roshbhatia/crysknife/previews/case-left.png

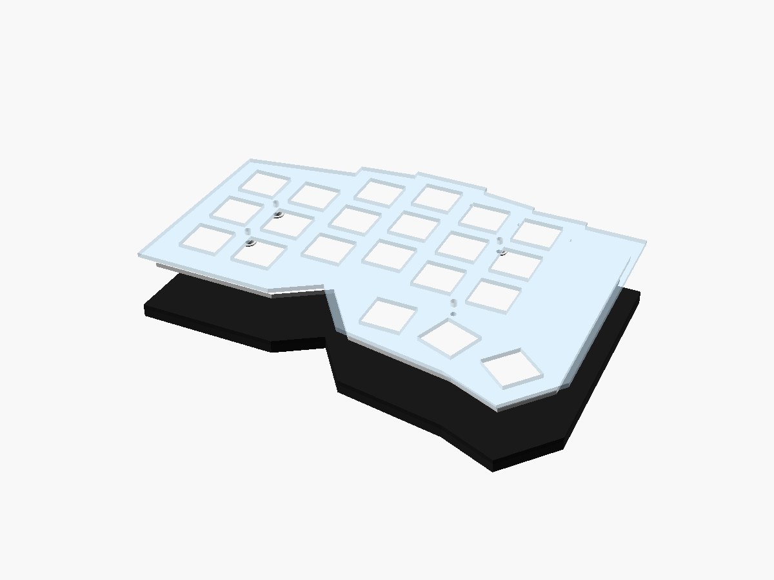
previews/case-left.png
