roshbhatia/crysknife/previews/case-right.png

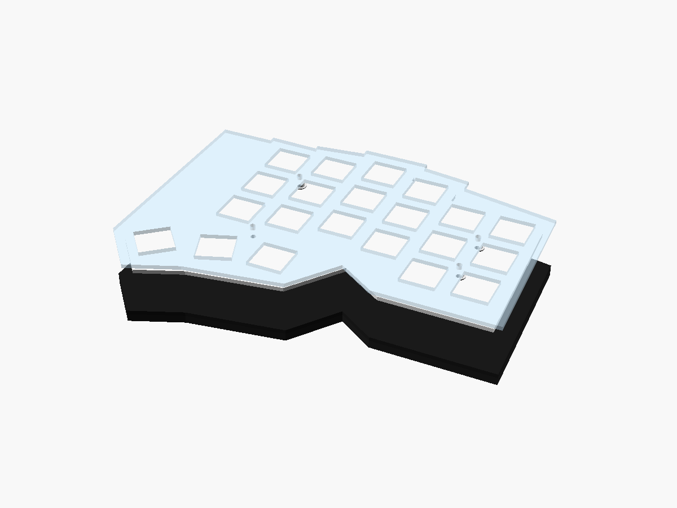
previews/case-right.png
