roshbhatia/crysknife/previews/enclosures/a-tpu-cnc-plates-section.png

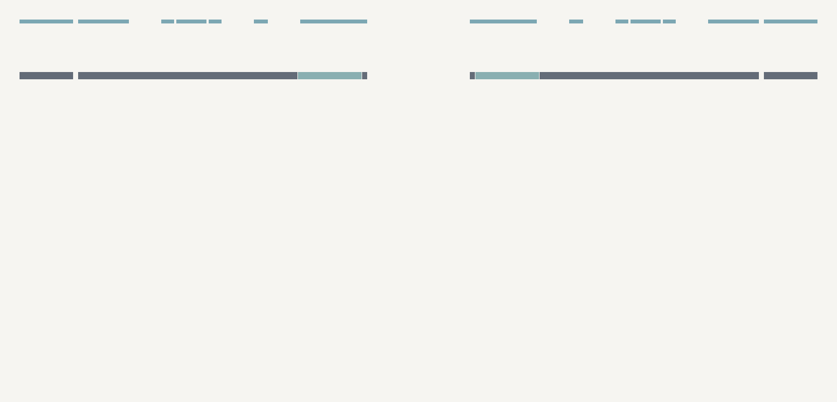
previews/enclosures/a-tpu-cnc-plates-section.png
