roshbhatia/crysknife/previews/enclosures/a-tpu-cnc-plates.png

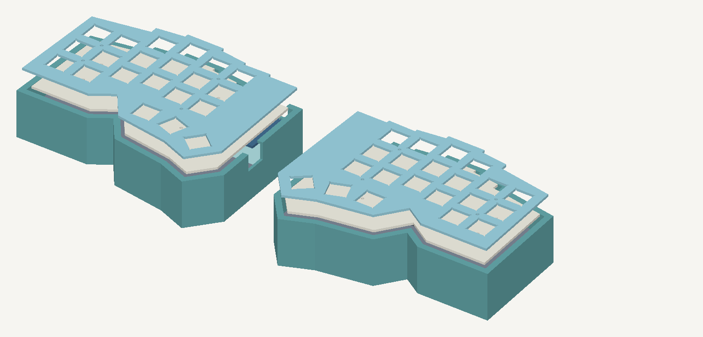
previews/enclosures/a-tpu-cnc-plates.png
