roshbhatia/crysknife/previews/enclosures/b-cnc-rigid-tray-section.png

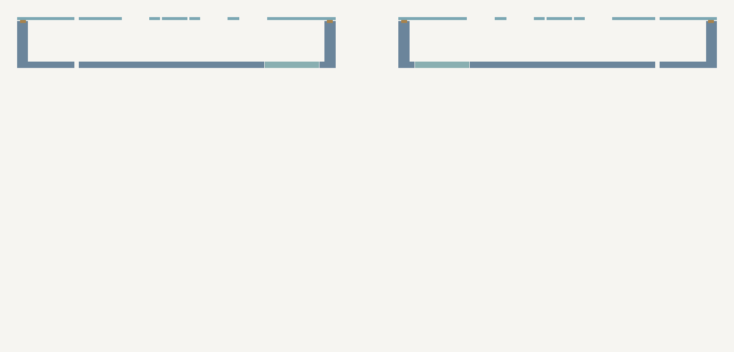
previews/enclosures/b-cnc-rigid-tray-section.png
