roshbhatia/crysknife/previews/enclosures/b-cnc-rigid-tray.png

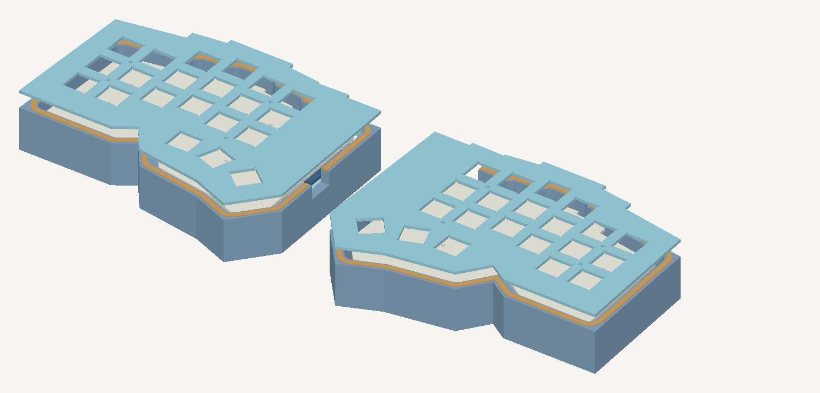
previews/enclosures/b-cnc-rigid-tray.png
