roshbhatia/crysknife/previews/enclosures/d-suspended-hybrid-section.png

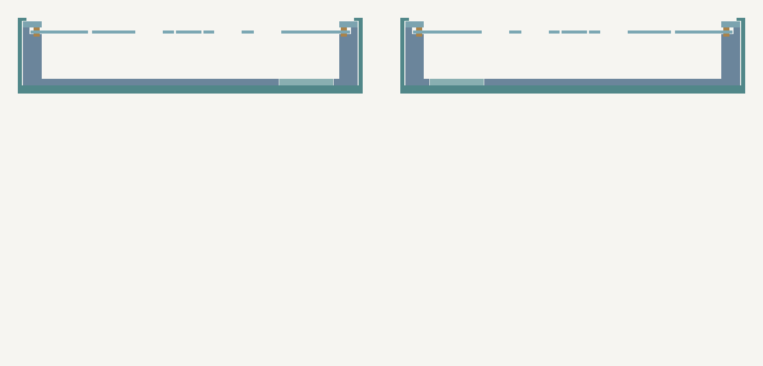
previews/enclosures/d-suspended-hybrid-section.png
