roshbhatia/crysknife/previews/enclosures/d-suspended-hybrid.png

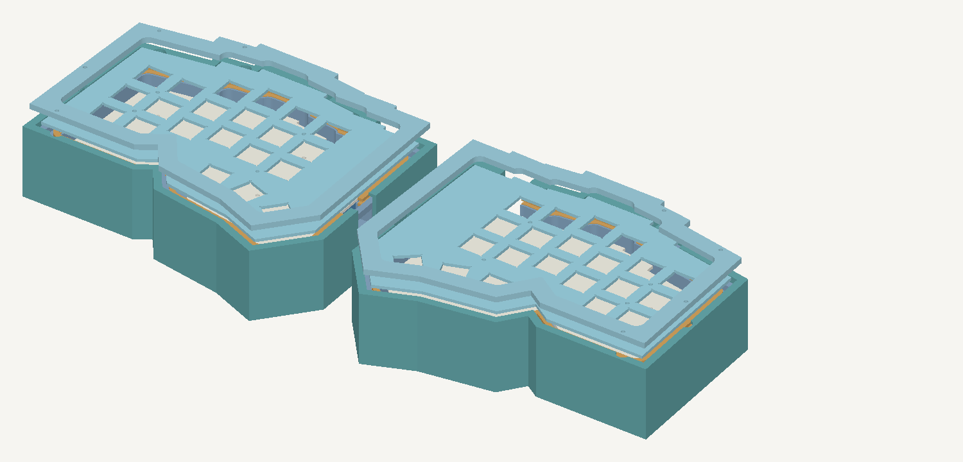
previews/enclosures/d-suspended-hybrid.png
