roshbhatia/crysknife/previews/enclosures/f-750/right-profile.png

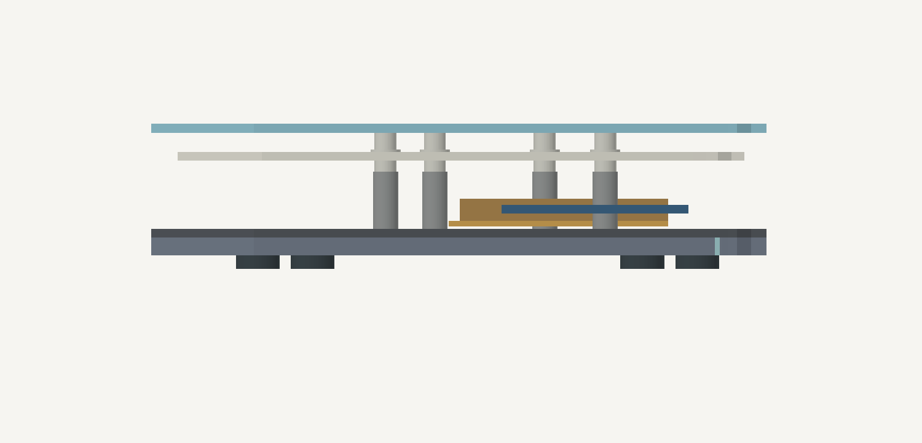
previews/enclosures/f-750/right-profile.png
