roshbhatia/crysknife/previews/enclosures/f-750/right-section.png

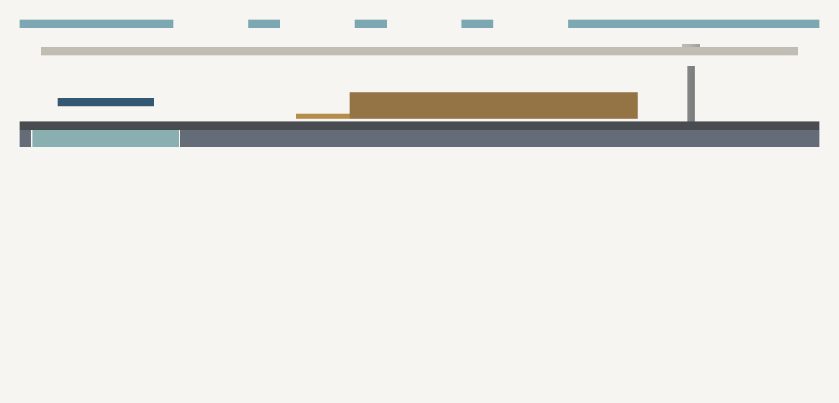
previews/enclosures/f-750/right-section.png
