roshbhatia/crysknife/previews/enclosures/heights/a-tpu-cnc-plates-side.png

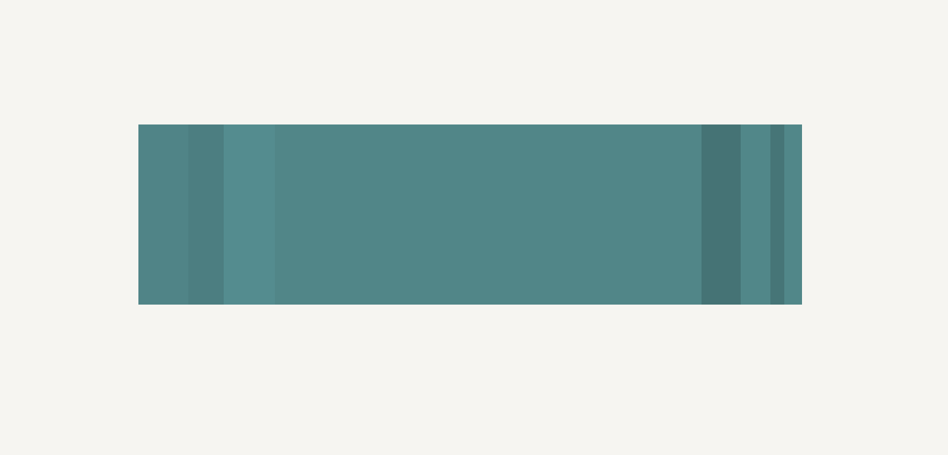
previews/enclosures/heights/a-tpu-cnc-plates-side.png
