roshbhatia/crysknife/previews/enclosures/heights/battery-750-active.png

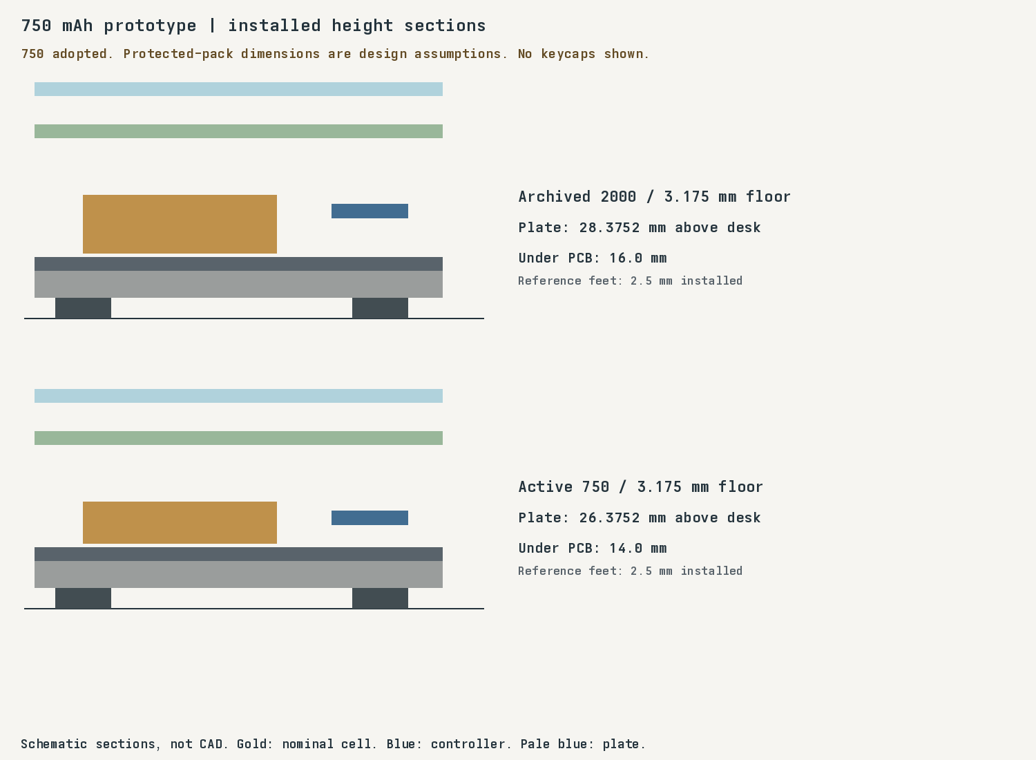
previews/enclosures/heights/battery-750-active.png
