roshbhatia/crysknife/previews/enclosures/heights/d-suspended-hybrid-side.png

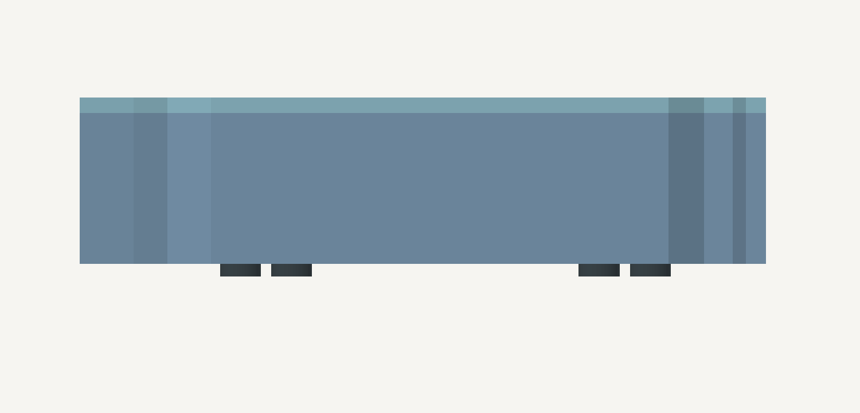
previews/enclosures/heights/d-suspended-hybrid-side.png
