roshbhatia/crysknife/previews/enclosures/heights/d-suspended-hybrid-tpu-side.png

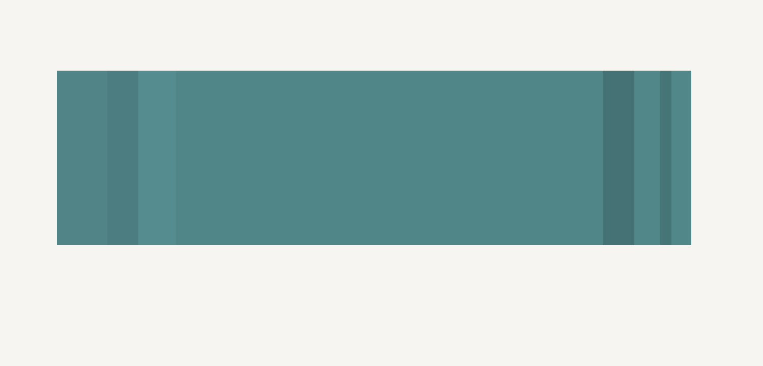
previews/enclosures/heights/d-suspended-hybrid-tpu-side.png
