roshbhatia/crysknife/previews/enclosures/heights/e-thin-rigid-sandwich-side.png

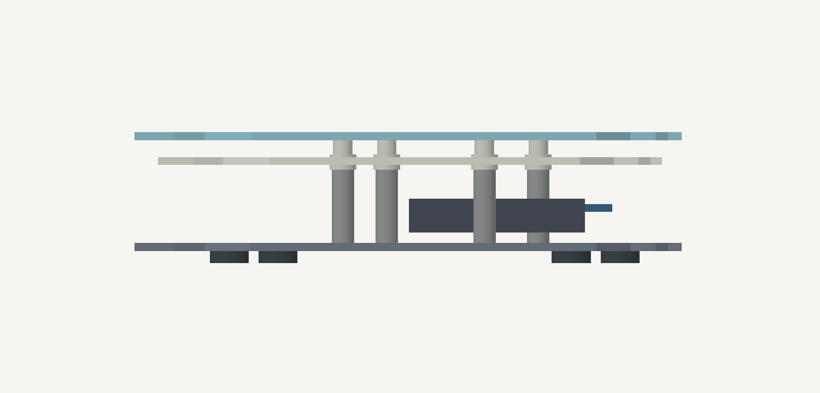
previews/enclosures/heights/e-thin-rigid-sandwich-side.png
