roshbhatia/crysknife/manufacturing/jlcpcb/left-bom.csv

Comment | Designator | Footprint | LCSC Part #
SSSS811101 | PWR1 | ceoloide:power_switch_smd_side | C109335
S2B-PH-K-S(LF)(SN) | JST1 | ceoloide:battery_connector_jst_ph_2 | C173752
CPG151101S11-16 | S1,S2,S3,S4,S5,S6,S7,S8,S9,S10,S11,S12,S13,S14,S15,S16,S17,S18,S19,S20,S21 | ceoloide:switch_mx | C41430893
PM254-1-12-Z-3.0-C | MCU1A,MCU1B | crysknife:MillMax_315_1x12 | C5156451
EVQPUL02K | RST1 | ceoloide:reset_switch_smd_side | C79175
1N4148W | D1,D2,D3,D4,D5,D6,D7,D8,D9,D10,D11,D12,D13,D14,D15,D16,D17,D18,D19,D20,D21 | ceoloide:diode_tht_sod123 | C81598
