roshbhatia/crysknife/out/3d/left-assembly.3mf

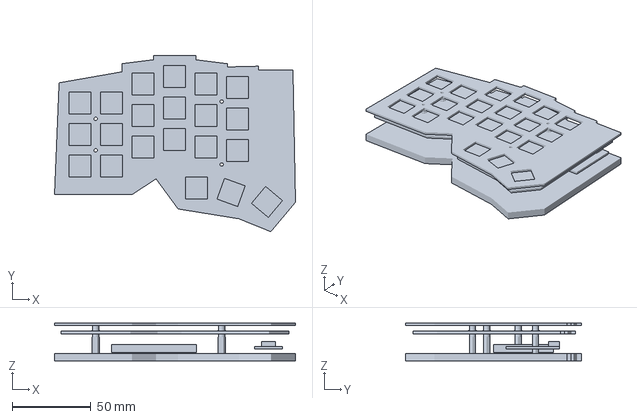
[picture p21: CAD file, 2026-10-13]
out/3d/left-assembly.3mf
153.1 x 112.0 x 23.9 mm
