roshbhatia/crysknife/manufacturing/enclosures/b-cnc-rigid-tray/left-tray.step

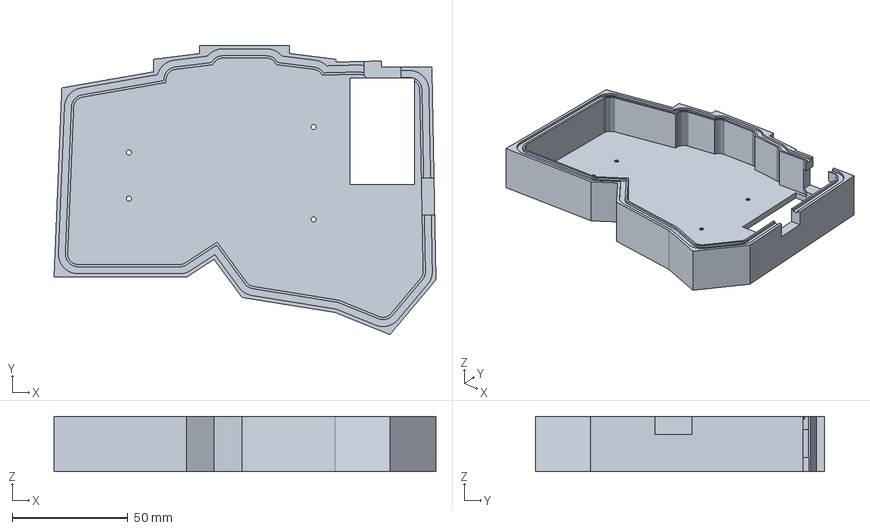
[picture p22: CAD file, 2026-10-13]
manufacturing/enclosures/b-cnc-rigid-tray/left-tray.step
165.4 x 125.2 x 24.0 mm
