roshbhatia/crysknife/manufacturing/enclosures/c-printed-tray-plate/left-tray.step

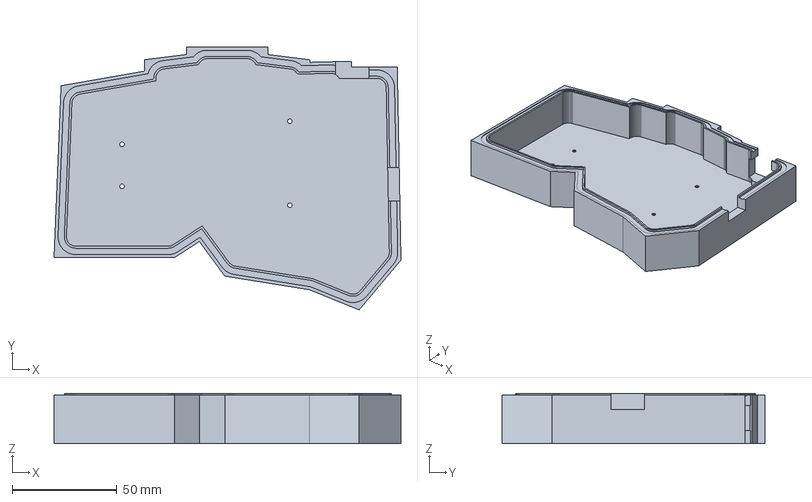
[picture p23: CAD file, 2026-10-13]
manufacturing/enclosures/c-printed-tray-plate/left-tray.step
165.4 x 125.2 x 24.0 mm
