roshbhatia/crysknife/manufacturing/enclosures/coupons/cnc-switch-fit.step

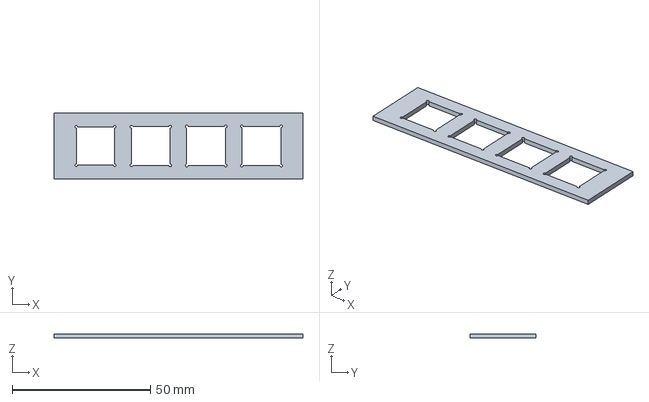
[picture p24: CAD file, 2026-10-13]
manufacturing/enclosures/coupons/cnc-switch-fit.step
90.0 x 24.0 x 1.60 mm
