roshbhatia/crysknife/manufacturing/enclosures/d-suspended-hybrid/right-top.step

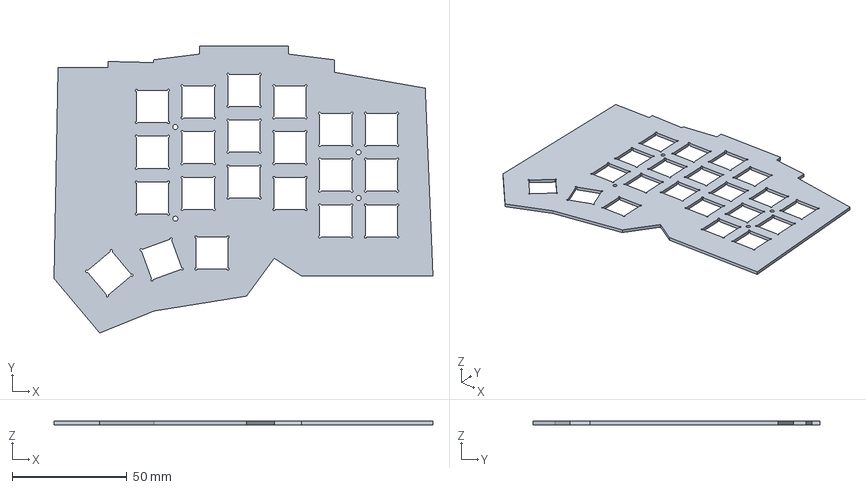
[picture p25: CAD file, 2026-10-13]
manufacturing/enclosures/d-suspended-hybrid/right-top.step
165.4 x 125.2 x 1.60 mm
