roshbhatia/crysknife/manufacturing/jlc3dp/left-sleeve.3mf

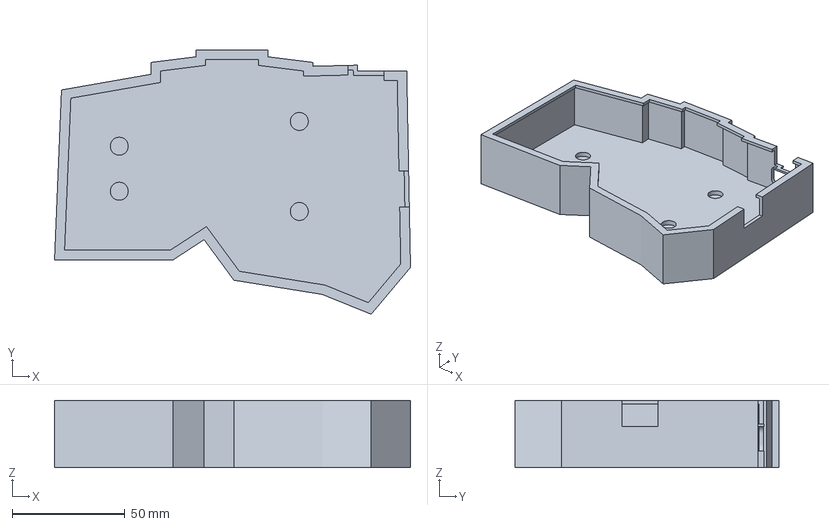
[picture p27: CAD file, 2026-10-13]
manufacturing/jlc3dp/left-sleeve.3mf
158.2 x 117.5 x 29.9 mm
