roshbhatia/crysknife/manufacturing/sendcutsend/left-bottom-flat.dxf

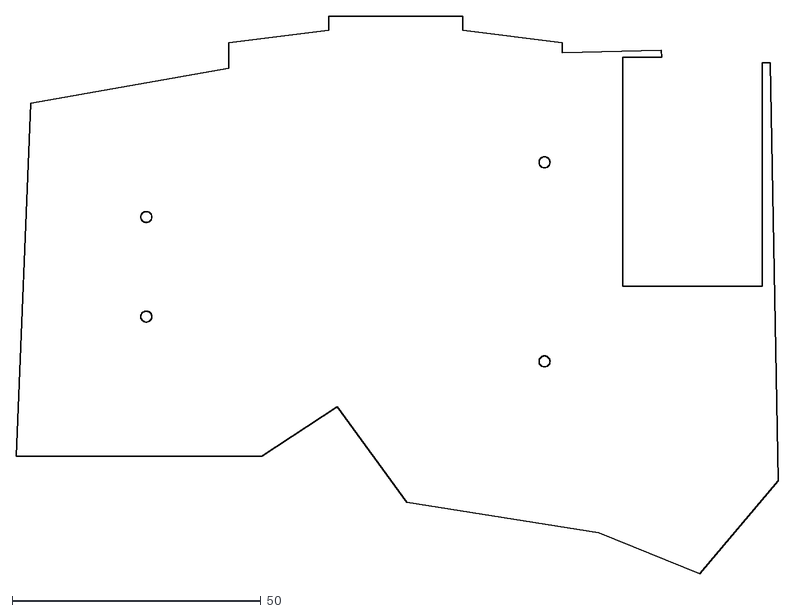
[picture p28: CAD file, 2026-10-13]
manufacturing/sendcutsend/left-bottom-flat.dxf
153.1 x 112.0
