roshbhatia/crysknife/out/3d/right-metal-bottom.3mf

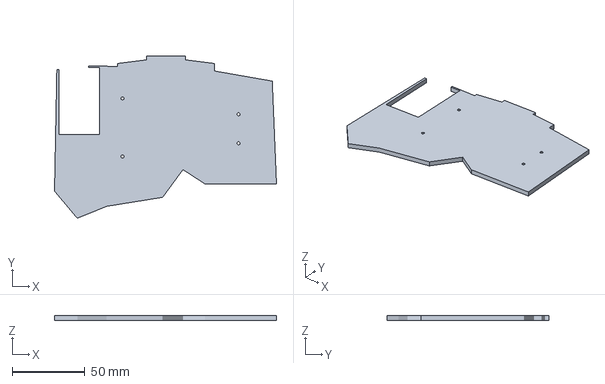
[picture p29: CAD file, 2026-10-13]
out/3d/right-metal-bottom.3mf
153.1 x 112.0 x 3.17 mm
