roshbhatia/crysknife/manufacturing/enclosures/b-cnc-rigid-tray/left-rf-insert.step

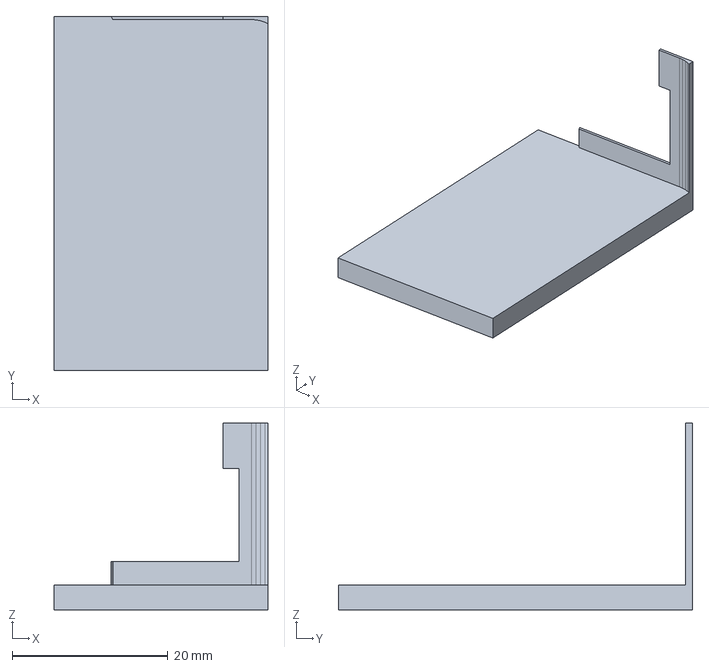
[picture p30: CAD file, 2026-10-13]
manufacturing/enclosures/b-cnc-rigid-tray/left-rf-insert.step
27.5 x 45.5 x 24.0 mm
