roshbhatia/crysknife/manufacturing/enclosures/c-printed-tray-plate/right-lower-gasket.step

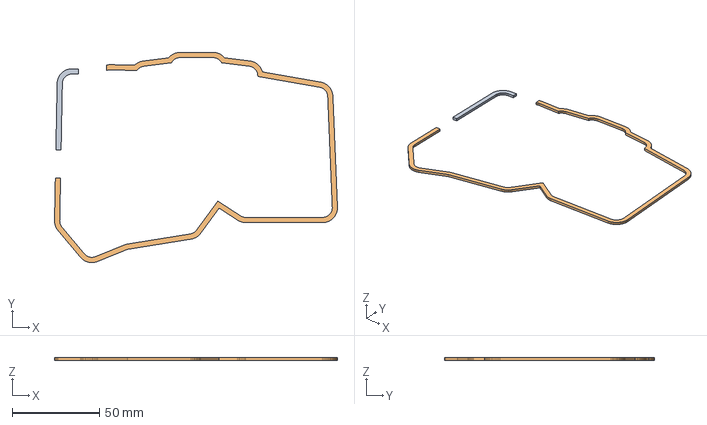
[picture p31: CAD file, 2026-10-13]
manufacturing/enclosures/c-printed-tray-plate/right-lower-gasket.step
161.9 x 120.2 x 1.50 mm
