roshbhatia/crysknife/manufacturing/enclosures/coupons/resin-switch-fit.step

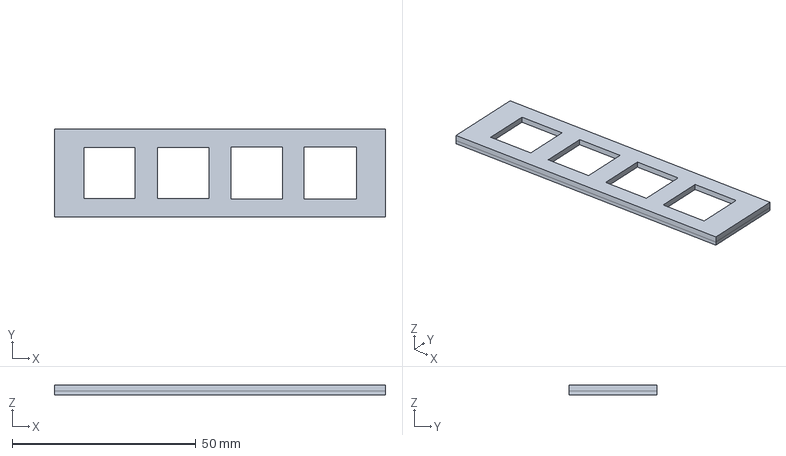
[picture p32: CAD file, 2026-10-13]
manufacturing/enclosures/coupons/resin-switch-fit.step
90.0 x 24.0 x 2.60 mm
