roshbhatia/crysknife/manufacturing/sendcutsend/right-bottom-flat.dxf

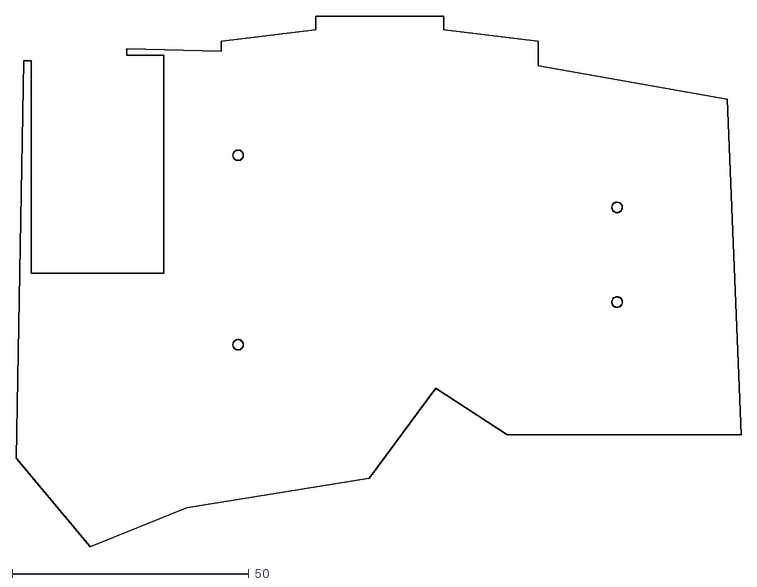
[picture p33: CAD file, 2026-10-13]
manufacturing/sendcutsend/right-bottom-flat.dxf
153.1 x 112.0
