roshbhatia/crysknife/manufacturing/enclosures/c-printed-tray-plate/left-top.step

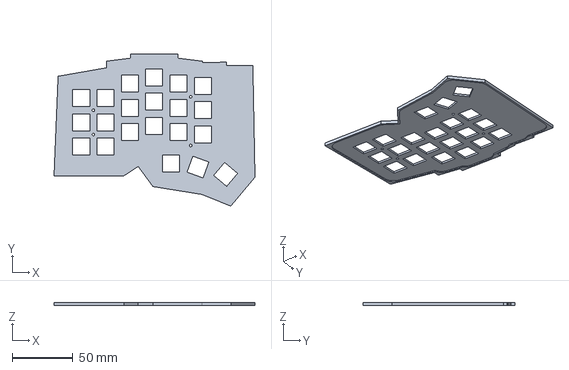
[picture p34: CAD file, 2026-10-13]
manufacturing/enclosures/c-printed-tray-plate/left-top.step
165.4 x 125.2 x 2.60 mm
