roshbhatia/crysknife/manufacturing/enclosures/d-suspended-hybrid/left-sleeve.step

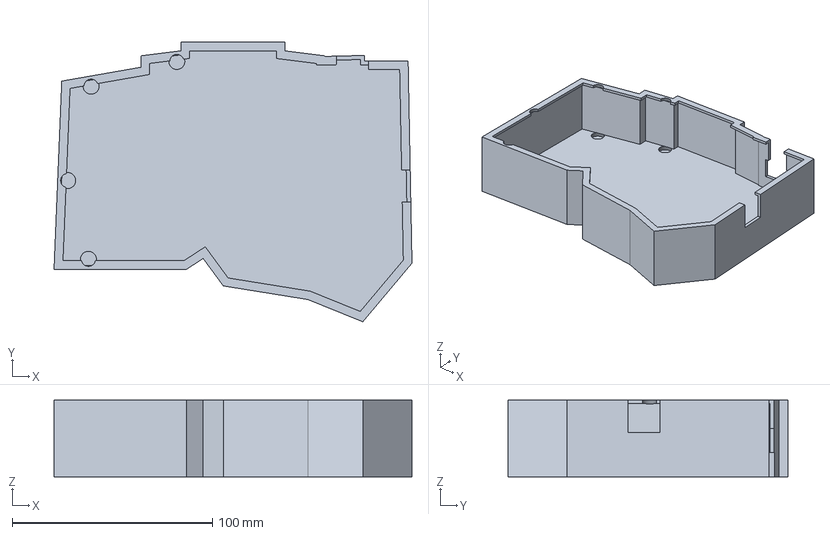
[picture p35: CAD file, 2026-10-13]
manufacturing/enclosures/d-suspended-hybrid/left-sleeve.step
178.7 x 139.5 x 38.4 mm
