roshbhatia/crysknife/manufacturing/enclosures/f-750-rigid-sandwich/right-rf-insert.step

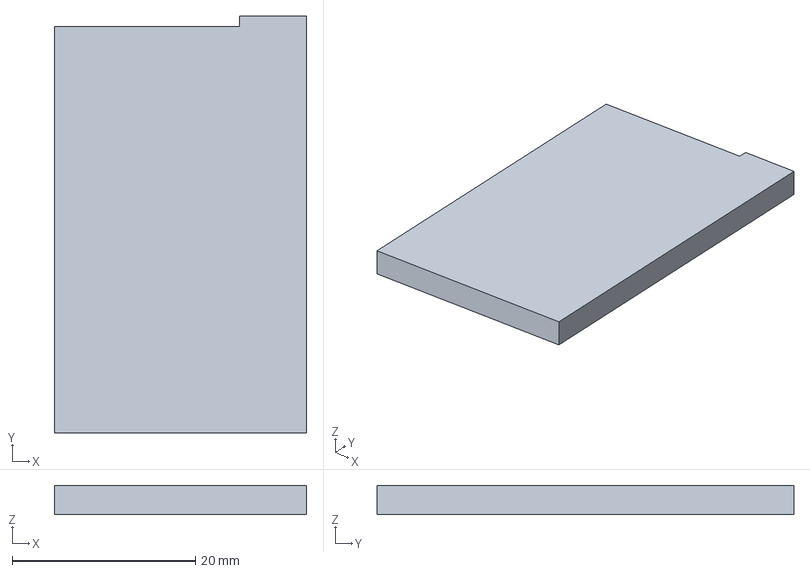
[picture p36: CAD file, 2026-10-13]
manufacturing/enclosures/f-750-rigid-sandwich/right-rf-insert.step
27.5 x 45.5 x 3.17 mm
