roshbhatia/crysknife/manufacturing/jlc3dp/left-bottom.3mf

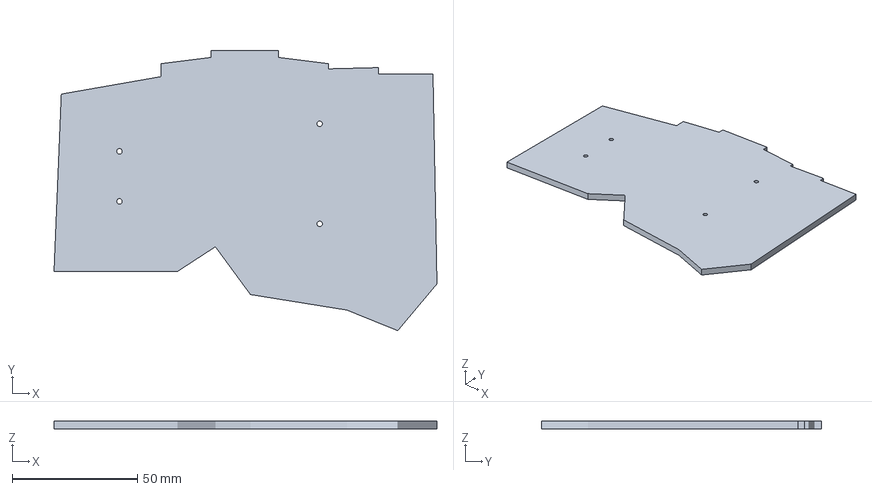
[picture p37: CAD file, 2026-10-09]
manufacturing/jlc3dp/left-bottom.3mf
153.1 x 112.0 x 3.17 mm
