roshbhatia/crysknife/manufacturing/sendcutsend/left-rf-insert.dxf

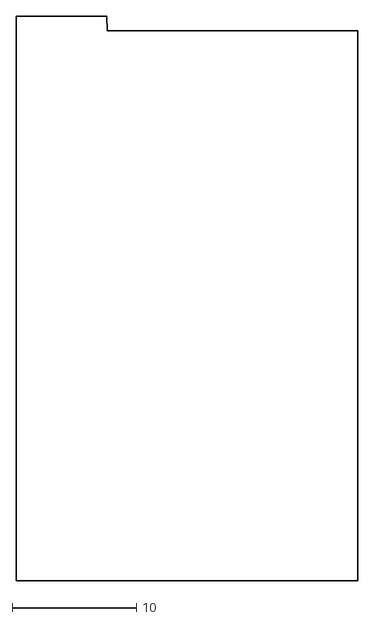
[picture p38: CAD file, 2026-10-13]
manufacturing/sendcutsend/left-rf-insert.dxf
27.5 x 45.5
