roshbhatia/crysknife/manufacturing/enclosures/d-suspended-hybrid/left-rf-insert.step

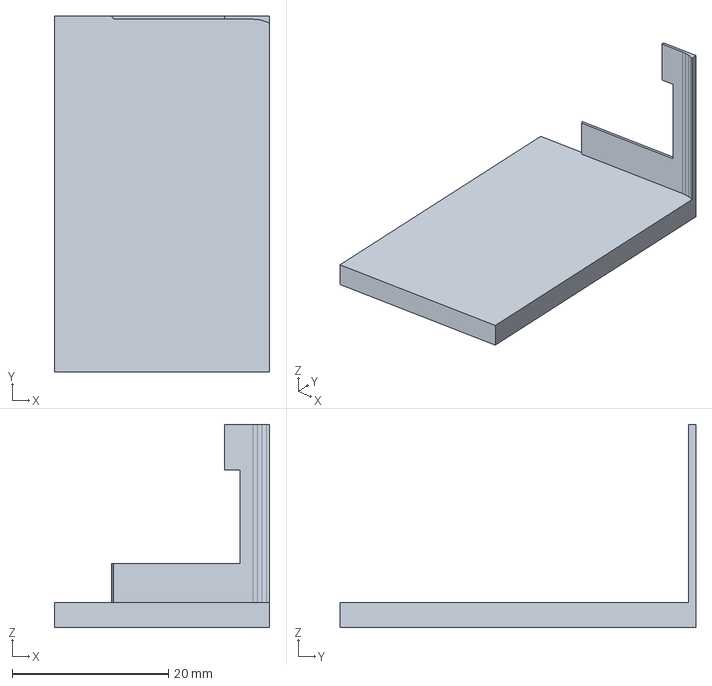
[picture p39: CAD file, 2026-10-13]
manufacturing/enclosures/d-suspended-hybrid/left-rf-insert.step
27.5 x 45.5 x 26.0 mm
