roshbhatia/crysknife/manufacturing/jlc3dp/right-plate.3mf

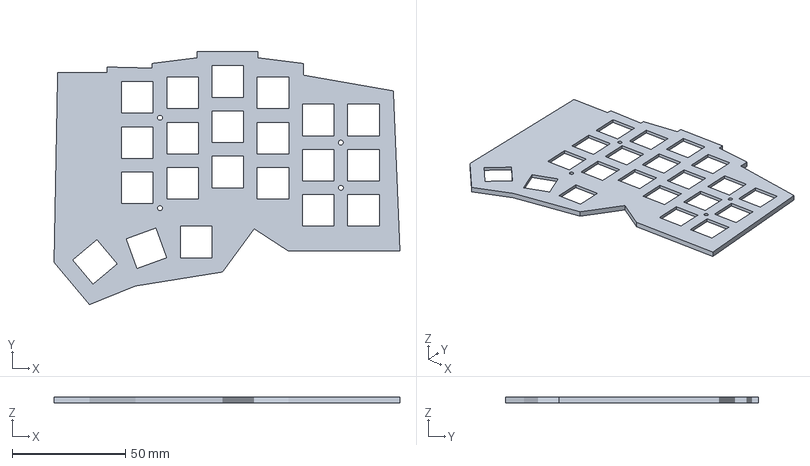
[picture p40: CAD file, 2026-10-09]
manufacturing/jlc3dp/right-plate.3mf
153.1 x 112.0 x 2.60 mm
