roshbhatia/crysknife/manufacturing/sendcutsend/right-rf-insert.dxf

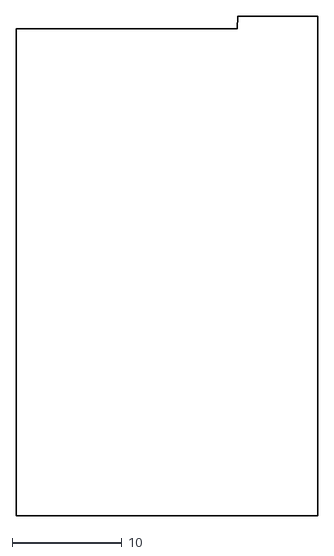
[picture p41: CAD file, 2026-10-13]
manufacturing/sendcutsend/right-rf-insert.dxf
27.5 x 45.5
