roshbhatia/crysknife/manufacturing/sendcutsend/right-plate.dxf

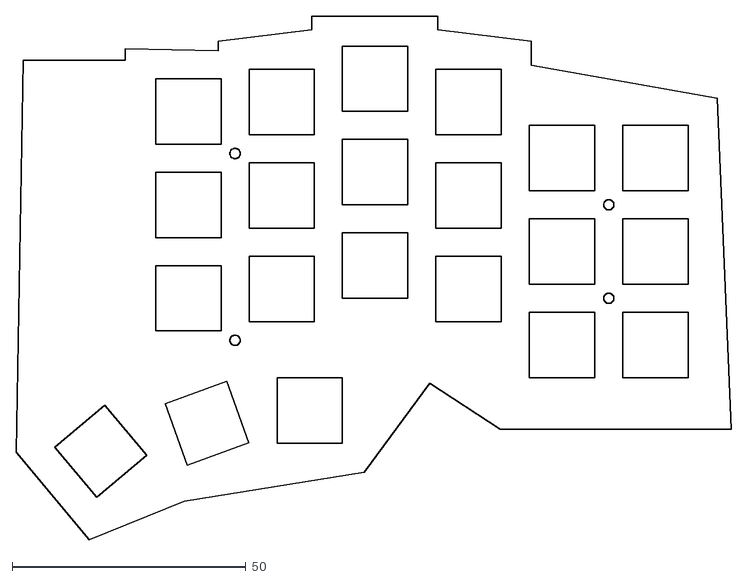
[picture p42: CAD file, 2026-10-09]
manufacturing/sendcutsend/right-plate.dxf
153.1 x 112.0
