roshbhatia/crysknife/manufacturing/enclosures/f-750-rigid-sandwich/right-top.step

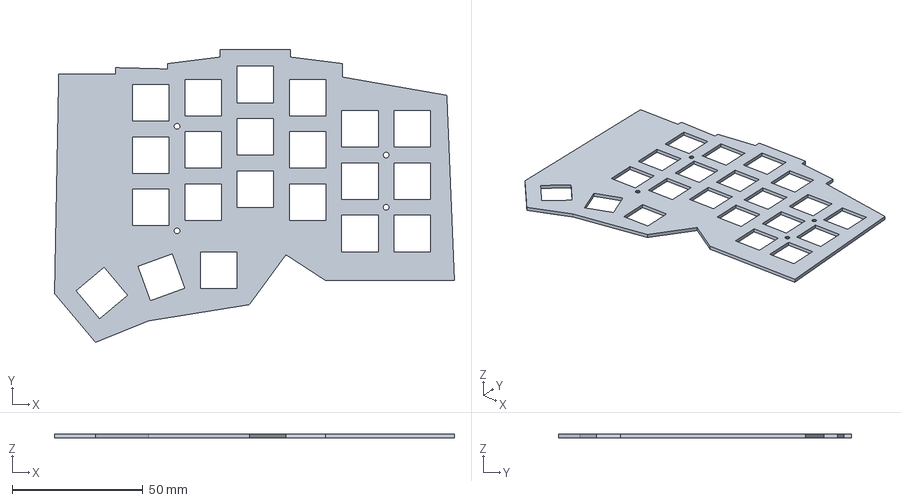
[picture p43: CAD file, 2026-10-13]
manufacturing/enclosures/f-750-rigid-sandwich/right-top.step
153.1 x 112.0 x 1.60 mm
