roshbhatia/crysknife/manufacturing/sendcutsend/left-plate.dxf

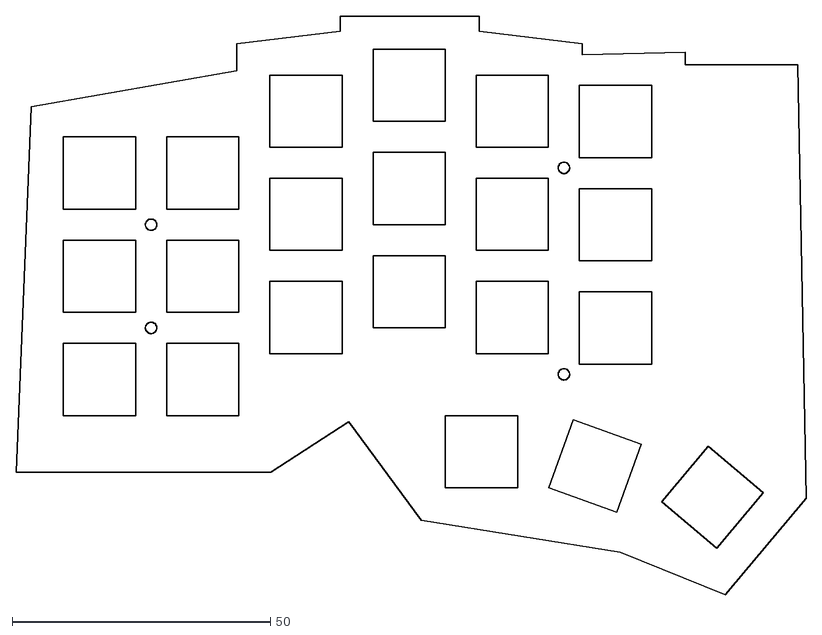
[picture p44: CAD file, 2026-10-09]
manufacturing/sendcutsend/left-plate.dxf
153.1 x 112.0
