roshbhatia/crysknife/manufacturing/sendcutsend/right-damping.dxf

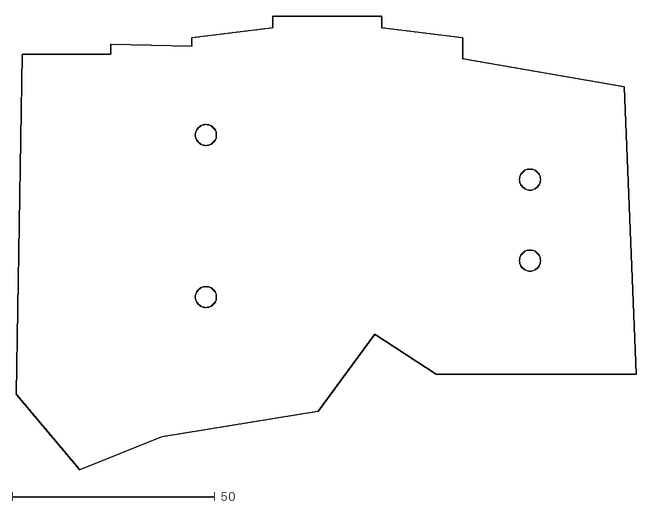
[picture p45: CAD file, 2026-10-09]
manufacturing/sendcutsend/right-damping.dxf
153.1 x 112.0
