roshbhatia/crysknife/manufacturing/sendcutsend/left-damping.dxf

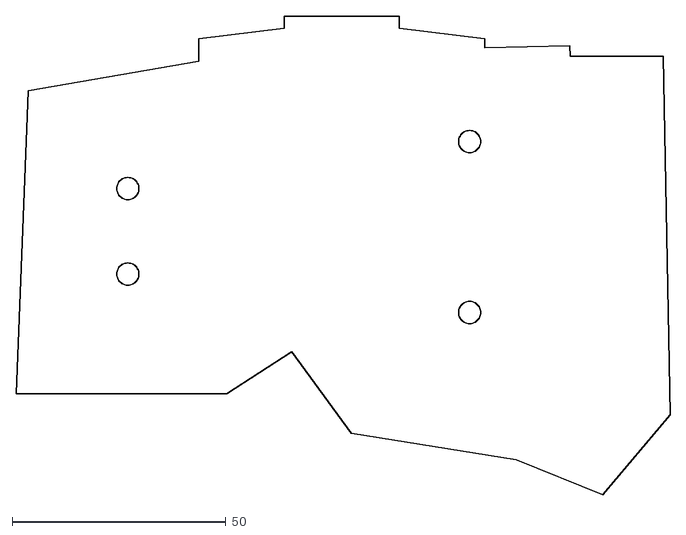
[picture p46: CAD file, 2026-10-09]
manufacturing/sendcutsend/left-damping.dxf
153.1 x 112.0
