roshbhatia/crysknife/manufacturing/enclosures/a-tpu-cnc-plates/right-sleeve.3mf

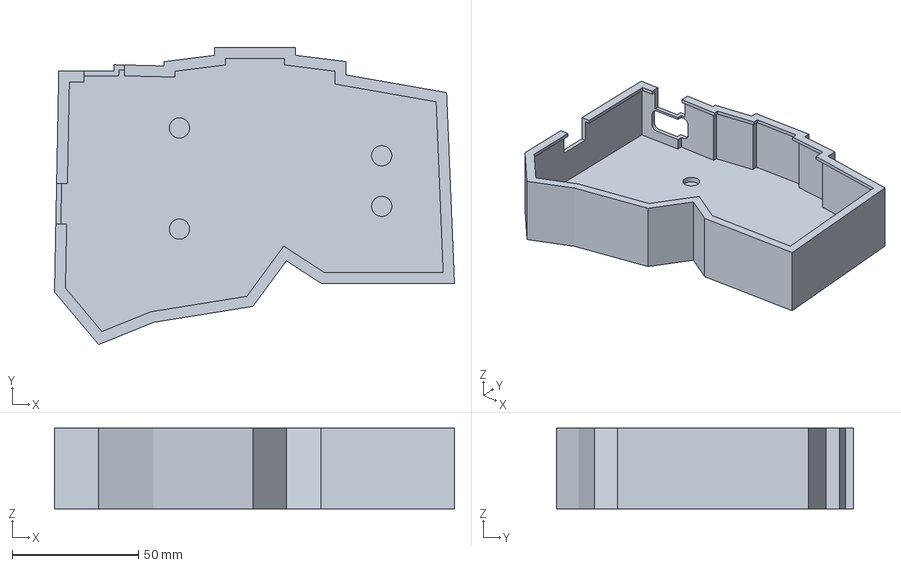
[picture p47: CAD file, 2026-10-09]
manufacturing/enclosures/a-tpu-cnc-plates/right-sleeve.3mf
158.2 x 117.5 x 31.9 mm
