roshbhatia/crysknife/manufacturing/enclosures/d-suspended-hybrid/left-tray.step

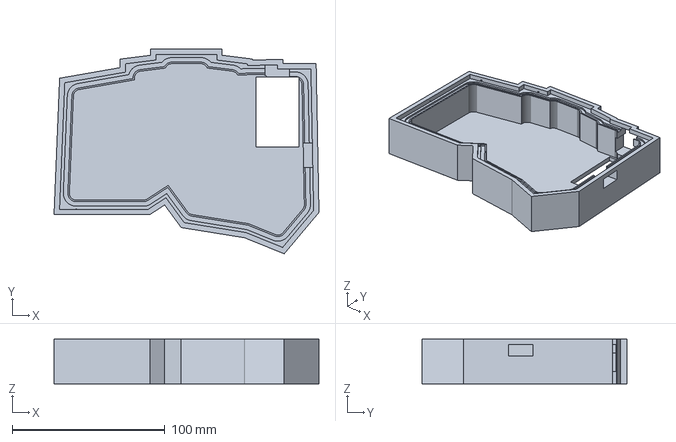
[picture p48: CAD file, 2026-10-13]
manufacturing/enclosures/d-suspended-hybrid/left-tray.step
173.5 x 134.0 x 29.4 mm
