roshbhatia/crysknife/manufacturing/sendcutsend/switch-fit-coupon.dxf

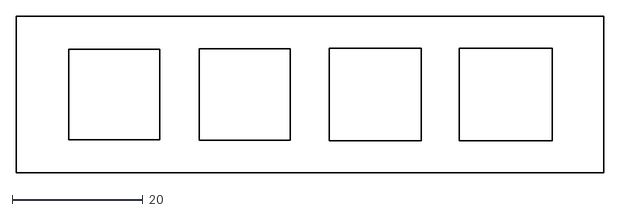
[picture p49: CAD file, 2026-10-09]
manufacturing/sendcutsend/switch-fit-coupon.dxf
90.0 x 24.0
