roshbhatia/crysknife/manufacturing/enclosures/d-suspended-hybrid/right-frame.step

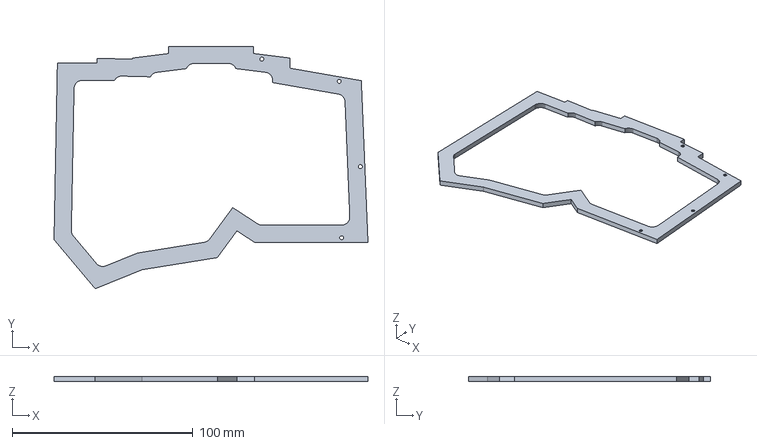
[picture p50: CAD file, 2026-10-13]
manufacturing/enclosures/d-suspended-hybrid/right-frame.step
173.5 x 134.0 x 3.00 mm
