roshbhatia/crysknife/case/parameters.scad

bottom_thickness = 3.175;
plate_thickness = 1.6002;
standoff_height = 12;
standoff_shim = 2;
standoff_shim_diameter = 4;
pcb_thickness = 1.6;
plate_to_pcb_gap = 3.5;
outline_expansion = 4;
bolt_diameter = 2.2;
switch_cutout = 14;
damping_thickness = 1.6002;
damping_bolt_diameter = 5.2;
standoff_diameter = 4.7;
standoff_across_flats = 4;
upper_spacer_height = 3;
upper_spacer_shim = 0.5;
upper_spacer_diameter = 4;
washer_diameter = 5.5;
top_screw_length = 12;
bottom_screw_length = 6;
screw_head_washer = 0.5;
standoff_thread_depth = 5;
controller_gap = 8;
controller_board_thickness = 1.6;
controller_component_height = 3;
controller_width = 18;
controller_length = 34;
