roshbhatia/crysknife/case/battery.scad

battery_nominal = [50, 34, 4];
battery_protected = [54, 38, 5];
battery_reserved = [64, 40, 6.5];
battery_component_reservation = 4.4;
battery_foam = 0.5;
battery_cover = 0.5;
