roshbhatia/crysknife/case/geometry.scad

left_geometry = [[[-72.4310476, -28.742944300000005], [-69.8210476, 34.742055699999995], [-29.821047599999986, 41.74305569999999], [-29.821047599999986, 46.742055699999995], [-9.821047599999986, 49.242055699999995], [-9.821047599999986, 51.6120557], [9.128952400000003, 51.6120557], [9.128952400000003, 49.242055699999995], [29.128952400000003, 46.742055699999995], [29.128952400000003, 44.1090557], [49.1289524, 44.6120557], [49.1819524, 42.242055699999995], [70.9319524, 42.242055699999995], [72.4310476, -36.29116690000001], [59.57529539999999, -51.61205570000001], [41.5456772, -44.3100719], [4.158952400000004, -38.2929443], [-11.126047599999993, -17.47294430000001], [-28.4310476, -28.742944300000005]], [[-60.4310476, -14.742944300000005, 0.0], [-60.4310476, 5.257055699999995, 0.0], [-60.4310476, 25.257055699999995, 0.0], [-40.4310476, -14.742944300000005, 0.0], [-40.4310476, 5.257055699999995, 0.0], [-40.4310476, 25.257055699999995, 0.0], [-20.4310476, -2.742944300000005, 0.0], [-20.4310476, 17.257055699999995, 0.0], [-20.4310476, 37.257055699999995, 0.0], [-0.4310475999999994, 2.257055699999995, 0.0], [-0.4310475999999994, 22.257055699999995, 0.0], [-0.4310475999999994, 42.257055699999995, 0.0], [19.5689524, -2.742944300000005, 0.0], [19.5689524, 17.257055699999995, 0.0], [19.5689524, 37.257055699999995, 0.0], [39.5689524, -4.742944300000005, 0.0], [39.5689524, 15.257055699999995, 0.0], [39.5689524, 35.257055699999995, 0.0], [13.5689524, -28.742944300000005, 0.0], [35.5689524, -31.492944300000005, -20.0], [58.34272709999999, -37.523735200000004, 50.0]], [[-50.4310476, 15.257055699999995], [-50.4310476, -4.742944300000005], [29.5689524, 26.257055699999995], [29.5689524, -13.742944300000005]], [59.27295240000001, 24.387055699999998], [59.27295240000001, 39.9570557], [68.8189524, -3.742944300000005], [-72.4310476, -51.61205570000001, 72.4310476, 51.6120557], [-8.4310476, 17.757055699999995], 2.2];
right_geometry = [[[72.4310476, -28.742944300000005], [69.82104759999999, 34.742055699999995], [29.821047599999986, 41.74305569999999], [29.821047599999986, 46.742055699999995], [9.821047599999986, 49.242055699999995], [9.821047599999986, 51.6120557], [-9.128952400000003, 51.6120557], [-9.128952400000003, 49.242055699999995], [-29.128952400000003, 46.742055699999995], [-29.128952400000003, 44.1090557], [-49.1289524, 44.6120557], [-49.1819524, 42.242055699999995], [-70.9319524, 42.242055699999995], [-72.4310476, -36.29116690000001], [-59.57529539999999, -51.61205570000001], [-41.5456772, -44.3100719], [-4.158952400000004, -38.2929443], [11.126047599999993, -17.47294430000001], [28.4310476, -28.742944300000005]], [[60.4310476, -14.742944300000005, 0.0], [60.4310476, 5.257055699999995, 0.0], [60.4310476, 25.257055699999995, 0.0], [40.4310476, -14.742944300000005, 0.0], [40.4310476, 5.257055699999995, 0.0], [40.4310476, 25.257055699999995, 0.0], [20.4310476, -2.742944300000005, 0.0], [20.4310476, 17.257055699999995, 0.0], [20.4310476, 37.257055699999995, 0.0], [0.4310475999999994, 2.257055699999995, 0.0], [0.4310475999999994, 22.257055699999995, 0.0], [0.4310475999999994, 42.257055699999995, 0.0], [-19.5689524, -2.742944300000005, 0.0], [-19.5689524, 17.257055699999995, 0.0], [-19.5689524, 37.257055699999995, 0.0], [-39.5689524, -4.742944300000005, 0.0], [-39.5689524, 15.257055699999995, 0.0], [-39.5689524, 35.257055699999995, 0.0], [-13.5689524, -28.742944300000005, 0.0], [-35.5689524, -31.492944300000005, 20.0], [-58.34272709999999, -37.523735200000004, -50.0]], [[50.4310476, 15.257055699999995], [50.4310476, -4.742944300000005], [-29.5689524, 26.257055699999995], [-29.5689524, -13.742944300000005]], [-59.27295240000001, 24.387055699999998], [-59.27295240000001, 39.9570557], [-68.8189524, -3.742944300000005], [-72.4310476, -51.61205570000001, 72.4310476, 51.6120557], [8.4310476, 17.757055699999995], 2.2];
