roshbhatia/crysknife/(list of files, cad)

Other CAD files:
out/3d/right-assembly.3mf
manufacturing/enclosures/d-suspended-hybrid/right-lower-gasket.step
manufacturing/enclosures/f-750-rigid-sandwich/right-bottom.step
manufacturing/jlc3dp/right-sleeve.3mf
out/3d/left-metal-bottom.3mf
manufacturing/enclosures/b-cnc-rigid-tray/left-lower-gasket.step
manufacturing/enclosures/b-cnc-rigid-tray/right-top.step
manufacturing/enclosures/c-printed-tray-plate/left-lower-gasket.step
manufacturing/enclosures/f-750-rigid-sandwich/left-rf-insert.step
manufacturing/enclosures/a-tpu-cnc-plates/right-pmma-bottom.step
manufacturing/enclosures/b-cnc-rigid-tray/right-lower-gasket.step
manufacturing/enclosures/c-printed-tray-plate/right-top.step
manufacturing/enclosures/d-suspended-hybrid/right-upper-gasket.step
manufacturing/enclosures/f-750-rigid-sandwich/left-damping.step
manufacturing/jlc3dp/left-plate.3mf
out/3d/right-printed-sleeve.3mf
manufacturing/enclosures/a-tpu-cnc-plates/left-pmma-bottom.step
manufacturing/enclosures/b-cnc-rigid-tray/right-tray.step
manufacturing/enclosures/c-printed-tray-plate/right-tray.step
manufacturing/enclosures/d-suspended-hybrid/right-rf-insert.step
manufacturing/jlc3dp/right-bottom.3mf
manufacturing/enclosures/b-cnc-rigid-tray/right-rf-insert.step
manufacturing/enclosures/d-suspended-hybrid/left-top.step
manufacturing/enclosures/f-750-rigid-sandwich/left-bottom.step
manufacturing/enclosures/b-cnc-rigid-tray/left-top.step
manufacturing/enclosures/d-suspended-hybrid/right-sleeve.step
manufacturing/enclosures/f-750-rigid-sandwich/left-top.step
out/3d/right-bottom.3mf
out/3d/left-plate.3mf
manufacturing/enclosures/a-tpu-cnc-plates/left-sleeve.3mf
manufacturing/enclosures/d-suspended-hybrid/left-upper-gasket.step
manufacturing/enclosures/d-suspended-hybrid/left-lower-gasket.step
manufacturing/enclosures/d-suspended-hybrid/right-tray.step
manufacturing/enclosures/d-suspended-hybrid/left-frame.step
case/tray-geometry.scad
manufacturing/enclosures/a-tpu-cnc-plates/left-bottom.dxf
manufacturing/enclosures/a-tpu-cnc-plates/left-bottom.step
manufacturing/enclosures/a-tpu-cnc-plates/left-bottom.stl
manufacturing/enclosures/a-tpu-cnc-plates/left-pmma-bottom.stl
manufacturing/enclosures/a-tpu-cnc-plates/left-rf-insert.step
manufacturing/enclosures/a-tpu-cnc-plates/left-rf-insert.stl
manufacturing/enclosures/a-tpu-cnc-plates/left-sleeve.stl
manufacturing/enclosures/a-tpu-cnc-plates/left-top.dxf
manufacturing/enclosures/a-tpu-cnc-plates/left-top.step
manufacturing/enclosures/a-tpu-cnc-plates/left-top.stl
manufacturing/enclosures/a-tpu-cnc-plates/right-bottom.dxf
manufacturing/enclosures/a-tpu-cnc-plates/right-bottom.step
manufacturing/enclosures/a-tpu-cnc-plates/right-bottom.stl
manufacturing/enclosures/a-tpu-cnc-plates/right-pmma-bottom.stl
manufacturing/enclosures/a-tpu-cnc-plates/right-rf-insert.step
manufacturing/enclosures/a-tpu-cnc-plates/right-rf-insert.stl
manufacturing/enclosures/a-tpu-cnc-plates/right-sleeve.stl
manufacturing/enclosures/a-tpu-cnc-plates/right-top.dxf
manufacturing/enclosures/a-tpu-cnc-plates/right-top.step
manufacturing/enclosures/a-tpu-cnc-plates/right-top.stl
manufacturing/enclosures/b-cnc-rigid-tray/left-lower-gasket.dxf
manufacturing/enclosures/b-cnc-rigid-tray/left-lower-gasket.stl
manufacturing/enclosures/b-cnc-rigid-tray/left-rf-insert.stl
manufacturing/enclosures/b-cnc-rigid-tray/left-top.dxf
manufacturing/enclosures/b-cnc-rigid-tray/left-top.stl
manufacturing/enclosures/b-cnc-rigid-tray/left-tray.stl
manufacturing/enclosures/b-cnc-rigid-tray/right-lower-gasket.dxf
manufacturing/enclosures/b-cnc-rigid-tray/right-lower-gasket.stl
manufacturing/enclosures/b-cnc-rigid-tray/right-rf-insert.stl
manufacturing/enclosures/b-cnc-rigid-tray/right-top.dxf
manufacturing/enclosures/b-cnc-rigid-tray/right-top.stl
manufacturing/enclosures/b-cnc-rigid-tray/right-tray.stl
manufacturing/enclosures/c-printed-tray-plate/left-lower-gasket.dxf
manufacturing/enclosures/c-printed-tray-plate/left-lower-gasket.stl
manufacturing/enclosures/c-printed-tray-plate/left-top.dxf
manufacturing/enclosures/c-printed-tray-plate/left-top.stl
manufacturing/enclosures/c-printed-tray-plate/left-tray.stl
manufacturing/enclosures/c-printed-tray-plate/right-lower-gasket.dxf
manufacturing/enclosures/c-printed-tray-plate/right-lower-gasket.stl
manufacturing/enclosures/c-printed-tray-plate/right-top.dxf
manufacturing/enclosures/c-printed-tray-plate/right-top.stl
manufacturing/enclosures/c-printed-tray-plate/right-tray.stl
manufacturing/enclosures/coupons/cnc-switch-fit.dxf
manufacturing/enclosures/coupons/cnc-switch-fit.stl
manufacturing/enclosures/coupons/resin-switch-fit.dxf
manufacturing/enclosures/coupons/resin-switch-fit.stl
manufacturing/enclosures/d-suspended-hybrid/left-frame.stl
manufacturing/enclosures/d-suspended-hybrid/left-lower-gasket.dxf
manufacturing/enclosures/d-suspended-hybrid/left-lower-gasket.stl
manufacturing/enclosures/d-suspended-hybrid/left-rf-insert.stl
manufacturing/enclosures/d-suspended-hybrid/left-sleeve.stl
manufacturing/enclosures/d-suspended-hybrid/left-top.dxf
manufacturing/enclosures/d-suspended-hybrid/left-top.stl
manufacturing/enclosures/d-suspended-hybrid/left-tray.stl
manufacturing/enclosures/d-suspended-hybrid/left-upper-gasket.dxf
manufacturing/enclosures/d-suspended-hybrid/left-upper-gasket.stl
manufacturing/enclosures/d-suspended-hybrid/right-frame.stl
manufacturing/enclosures/d-suspended-hybrid/right-lower-gasket.dxf
manufacturing/enclosures/d-suspended-hybrid/right-lower-gasket.stl
manufacturing/enclosures/d-suspended-hybrid/right-rf-insert.stl
manufacturing/enclosures/d-suspended-hybrid/right-sleeve.stl
manufacturing/enclosures/d-suspended-hybrid/right-top.dxf
manufacturing/enclosures/d-suspended-hybrid/right-top.stl
manufacturing/enclosures/d-suspended-hybrid/right-tray.stl
manufacturing/enclosures/d-suspended-hybrid/right-upper-gasket.dxf
manufacturing/enclosures/d-suspended-hybrid/right-upper-gasket.stl
manufacturing/enclosures/e-thin-rigid-sandwich/left-bottom.dxf
manufacturing/enclosures/e-thin-rigid-sandwich/left-bottom.step
manufacturing/enclosures/e-thin-rigid-sandwich/left-bottom.stl
manufacturing/enclosures/e-thin-rigid-sandwich/left-rf-insert.dxf
manufacturing/enclosures/e-thin-rigid-sandwich/left-rf-insert.step
manufacturing/enclosures/e-thin-rigid-sandwich/left-rf-insert.stl
manufacturing/enclosures/e-thin-rigid-sandwich/left-top.dxf
manufacturing/enclosures/e-thin-rigid-sandwich/left-top.step
manufacturing/enclosures/e-thin-rigid-sandwich/left-top.stl
manufacturing/enclosures/e-thin-rigid-sandwich/right-bottom.dxf
manufacturing/enclosures/e-thin-rigid-sandwich/right-bottom.step
manufacturing/enclosures/e-thin-rigid-sandwich/right-bottom.stl
manufacturing/enclosures/e-thin-rigid-sandwich/right-rf-insert.dxf
manufacturing/enclosures/e-thin-rigid-sandwich/right-rf-insert.step
manufacturing/enclosures/e-thin-rigid-sandwich/right-rf-insert.stl
manufacturing/enclosures/e-thin-rigid-sandwich/right-top.dxf
manufacturing/enclosures/e-thin-rigid-sandwich/right-top.step
manufacturing/enclosures/e-thin-rigid-sandwich/right-top.stl
manufacturing/enclosures/f-750-rigid-sandwich/left-bottom.dxf
manufacturing/enclosures/f-750-rigid-sandwich/left-bottom.stl
manufacturing/enclosures/f-750-rigid-sandwich/left-damping.dxf
manufacturing/enclosures/f-750-rigid-sandwich/left-damping.stl
manufacturing/enclosures/f-750-rigid-sandwich/left-rf-insert.dxf
manufacturing/enclosures/f-750-rigid-sandwich/left-rf-insert.stl
manufacturing/enclosures/f-750-rigid-sandwich/left-top.dxf
manufacturing/enclosures/f-750-rigid-sandwich/left-top.stl
manufacturing/enclosures/f-750-rigid-sandwich/right-bottom.dxf
manufacturing/enclosures/f-750-rigid-sandwich/right-bottom.stl
manufacturing/enclosures/f-750-rigid-sandwich/right-damping.dxf
manufacturing/enclosures/f-750-rigid-sandwich/right-damping.stl
manufacturing/enclosures/f-750-rigid-sandwich/right-rf-insert.dxf
manufacturing/enclosures/f-750-rigid-sandwich/right-rf-insert.stl
manufacturing/enclosures/f-750-rigid-sandwich/right-top.dxf
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
