roshbhatia/crysknife/previews/enclosures/c-printed-tray-plate-section.png

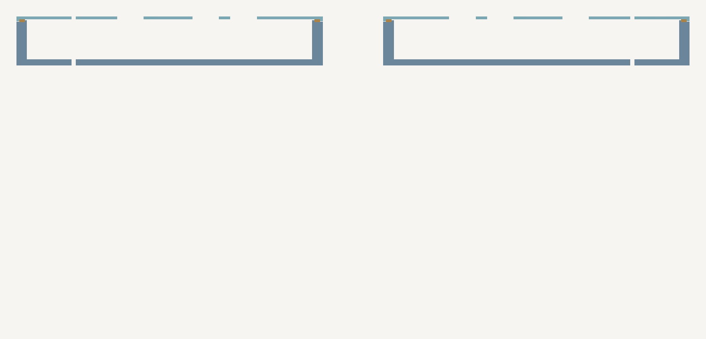
previews/enclosures/c-printed-tray-plate-section.png
