roshbhatia/crysknife/previews/enclosures/f-750/left-assembled.png

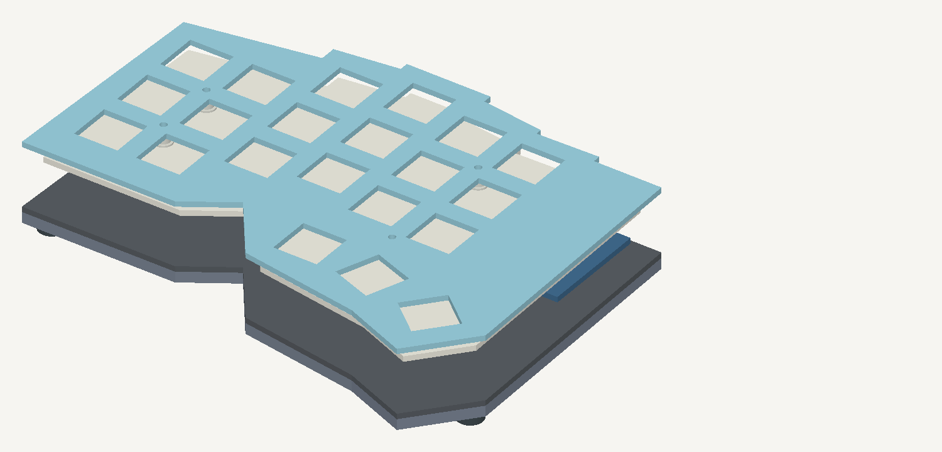
previews/enclosures/f-750/left-assembled.png
