roshbhatia/crysknife/previews/enclosures/f-750/right-assembled.png

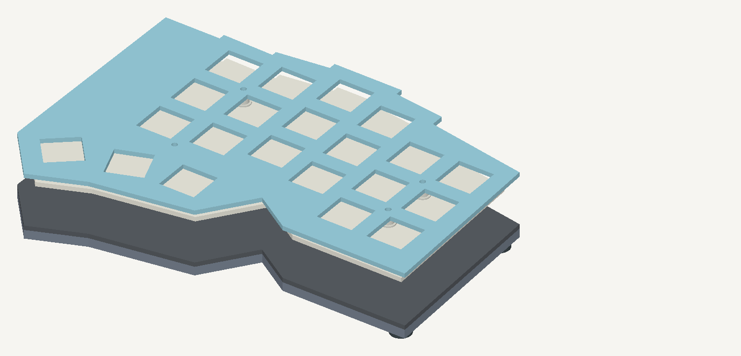
previews/enclosures/f-750/right-assembled.png
