roshbhatia/crysknife/previews/printed-case-right.png

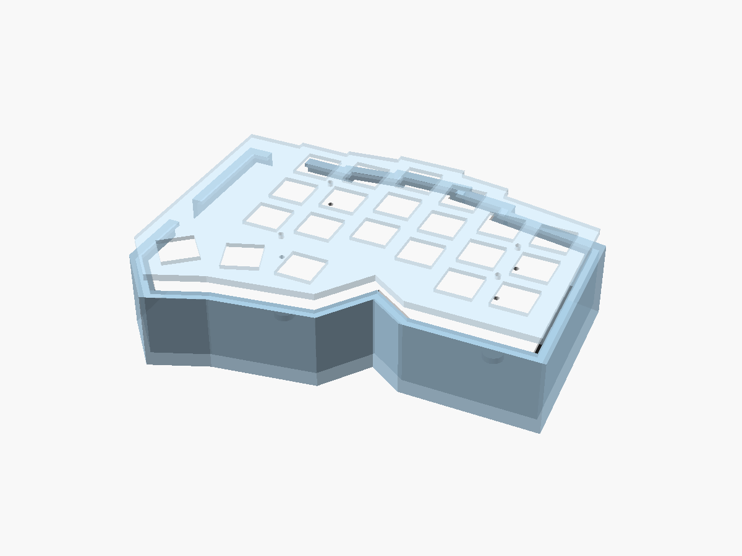
previews/printed-case-right.png
