roshbhatia/crysknife/out/kicad/left.pdf

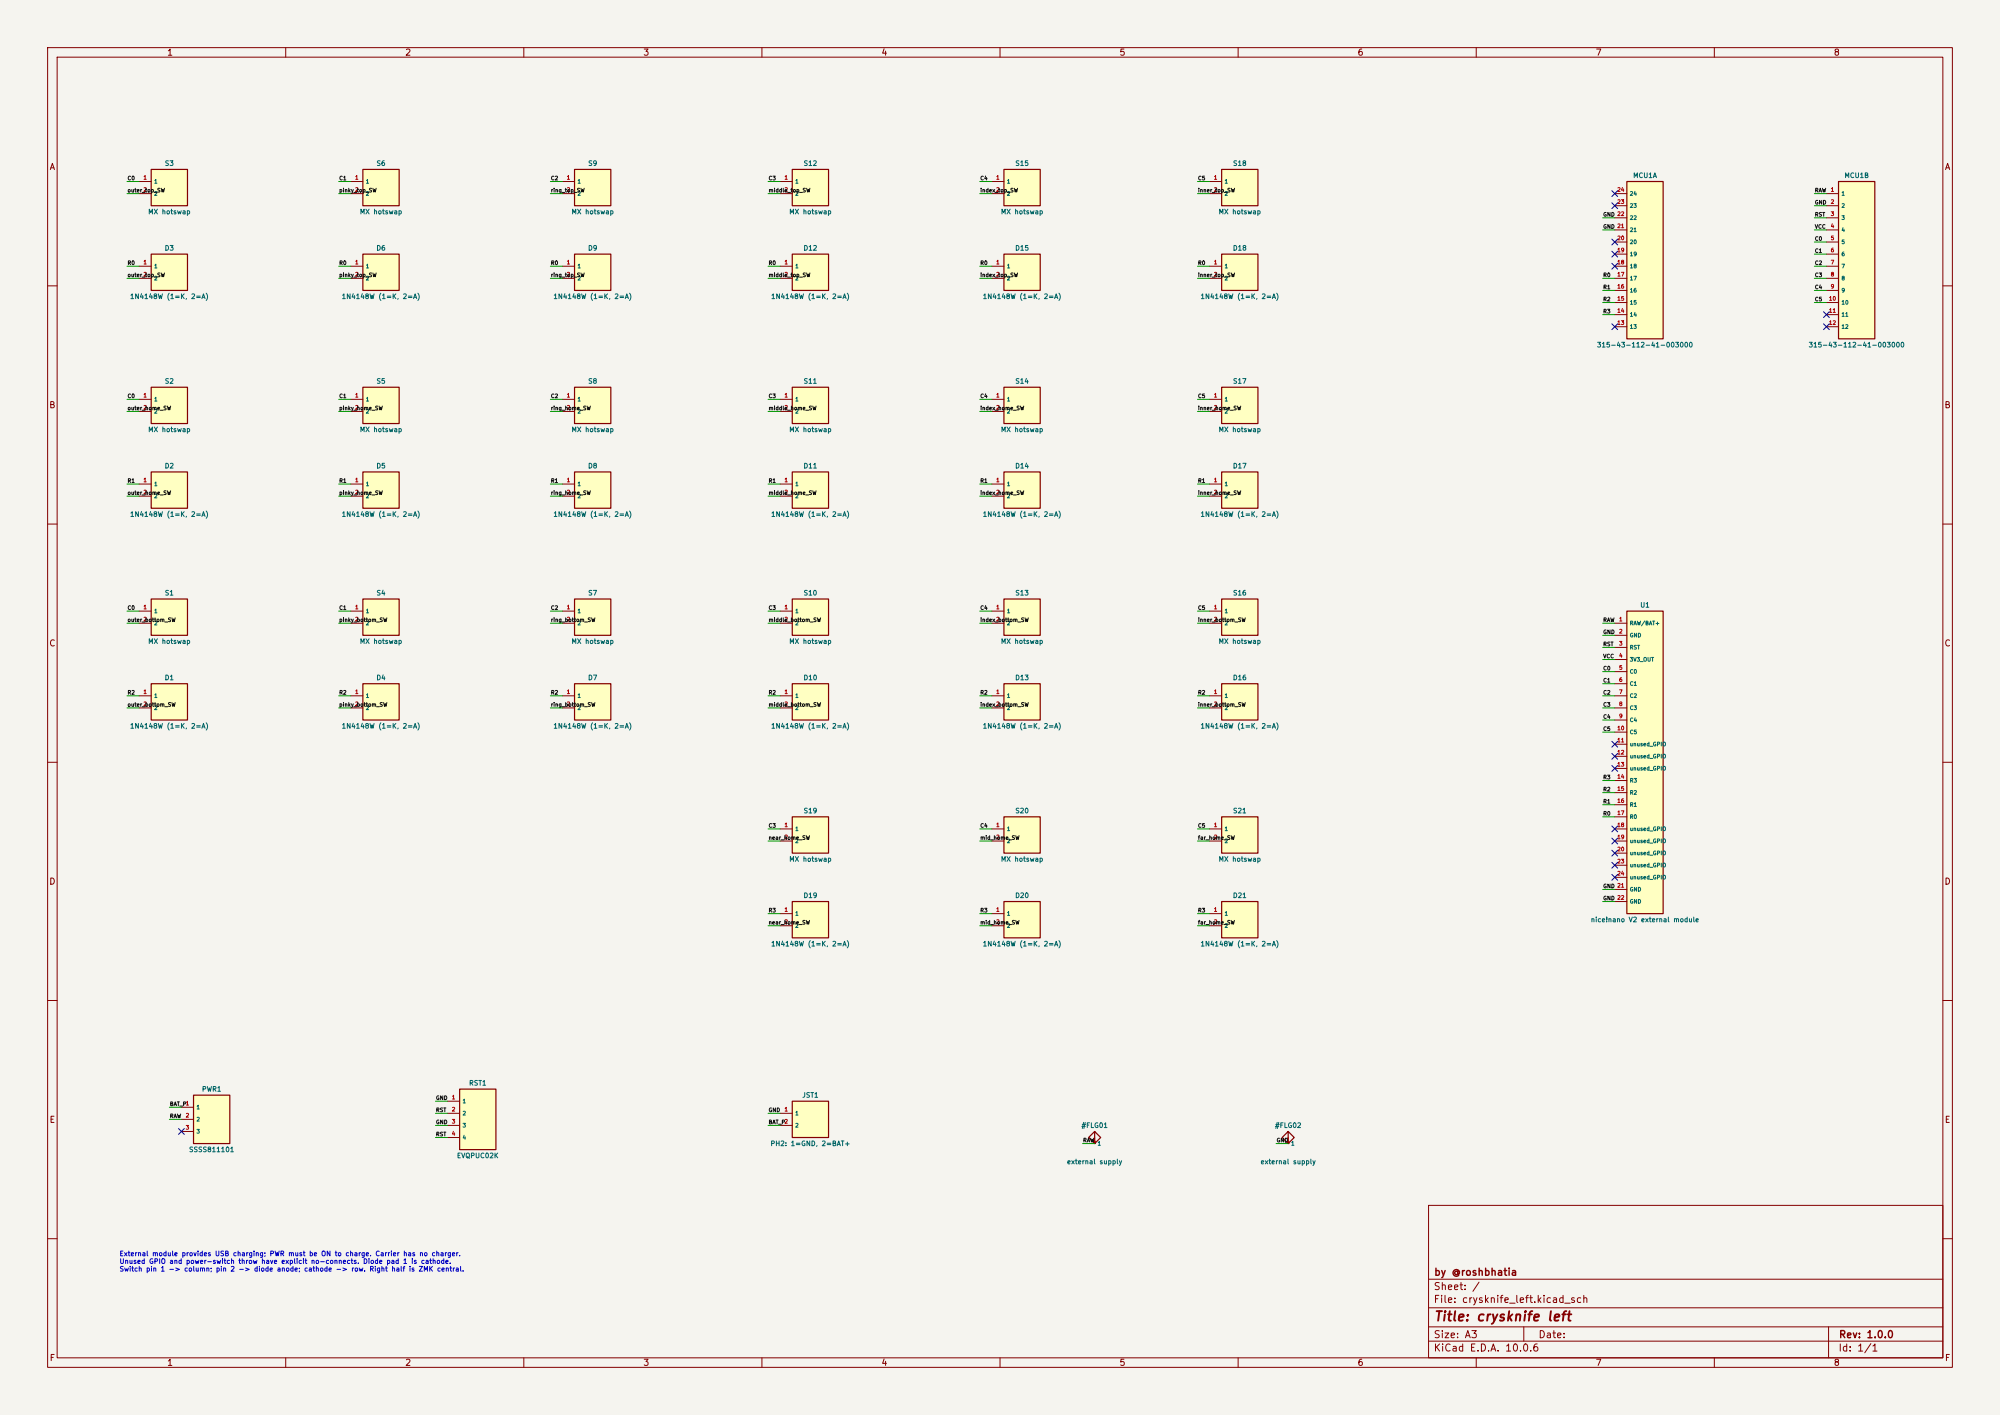
[picture p62: page 1]

nice!nano V2 external module

Size: A3 | Rev: 1.0.0 | F Date:
KiCad E.D.A. 10.0.6 | Id: 1/1
