roshbhatia/crysknife/out/kicad/right.pdf

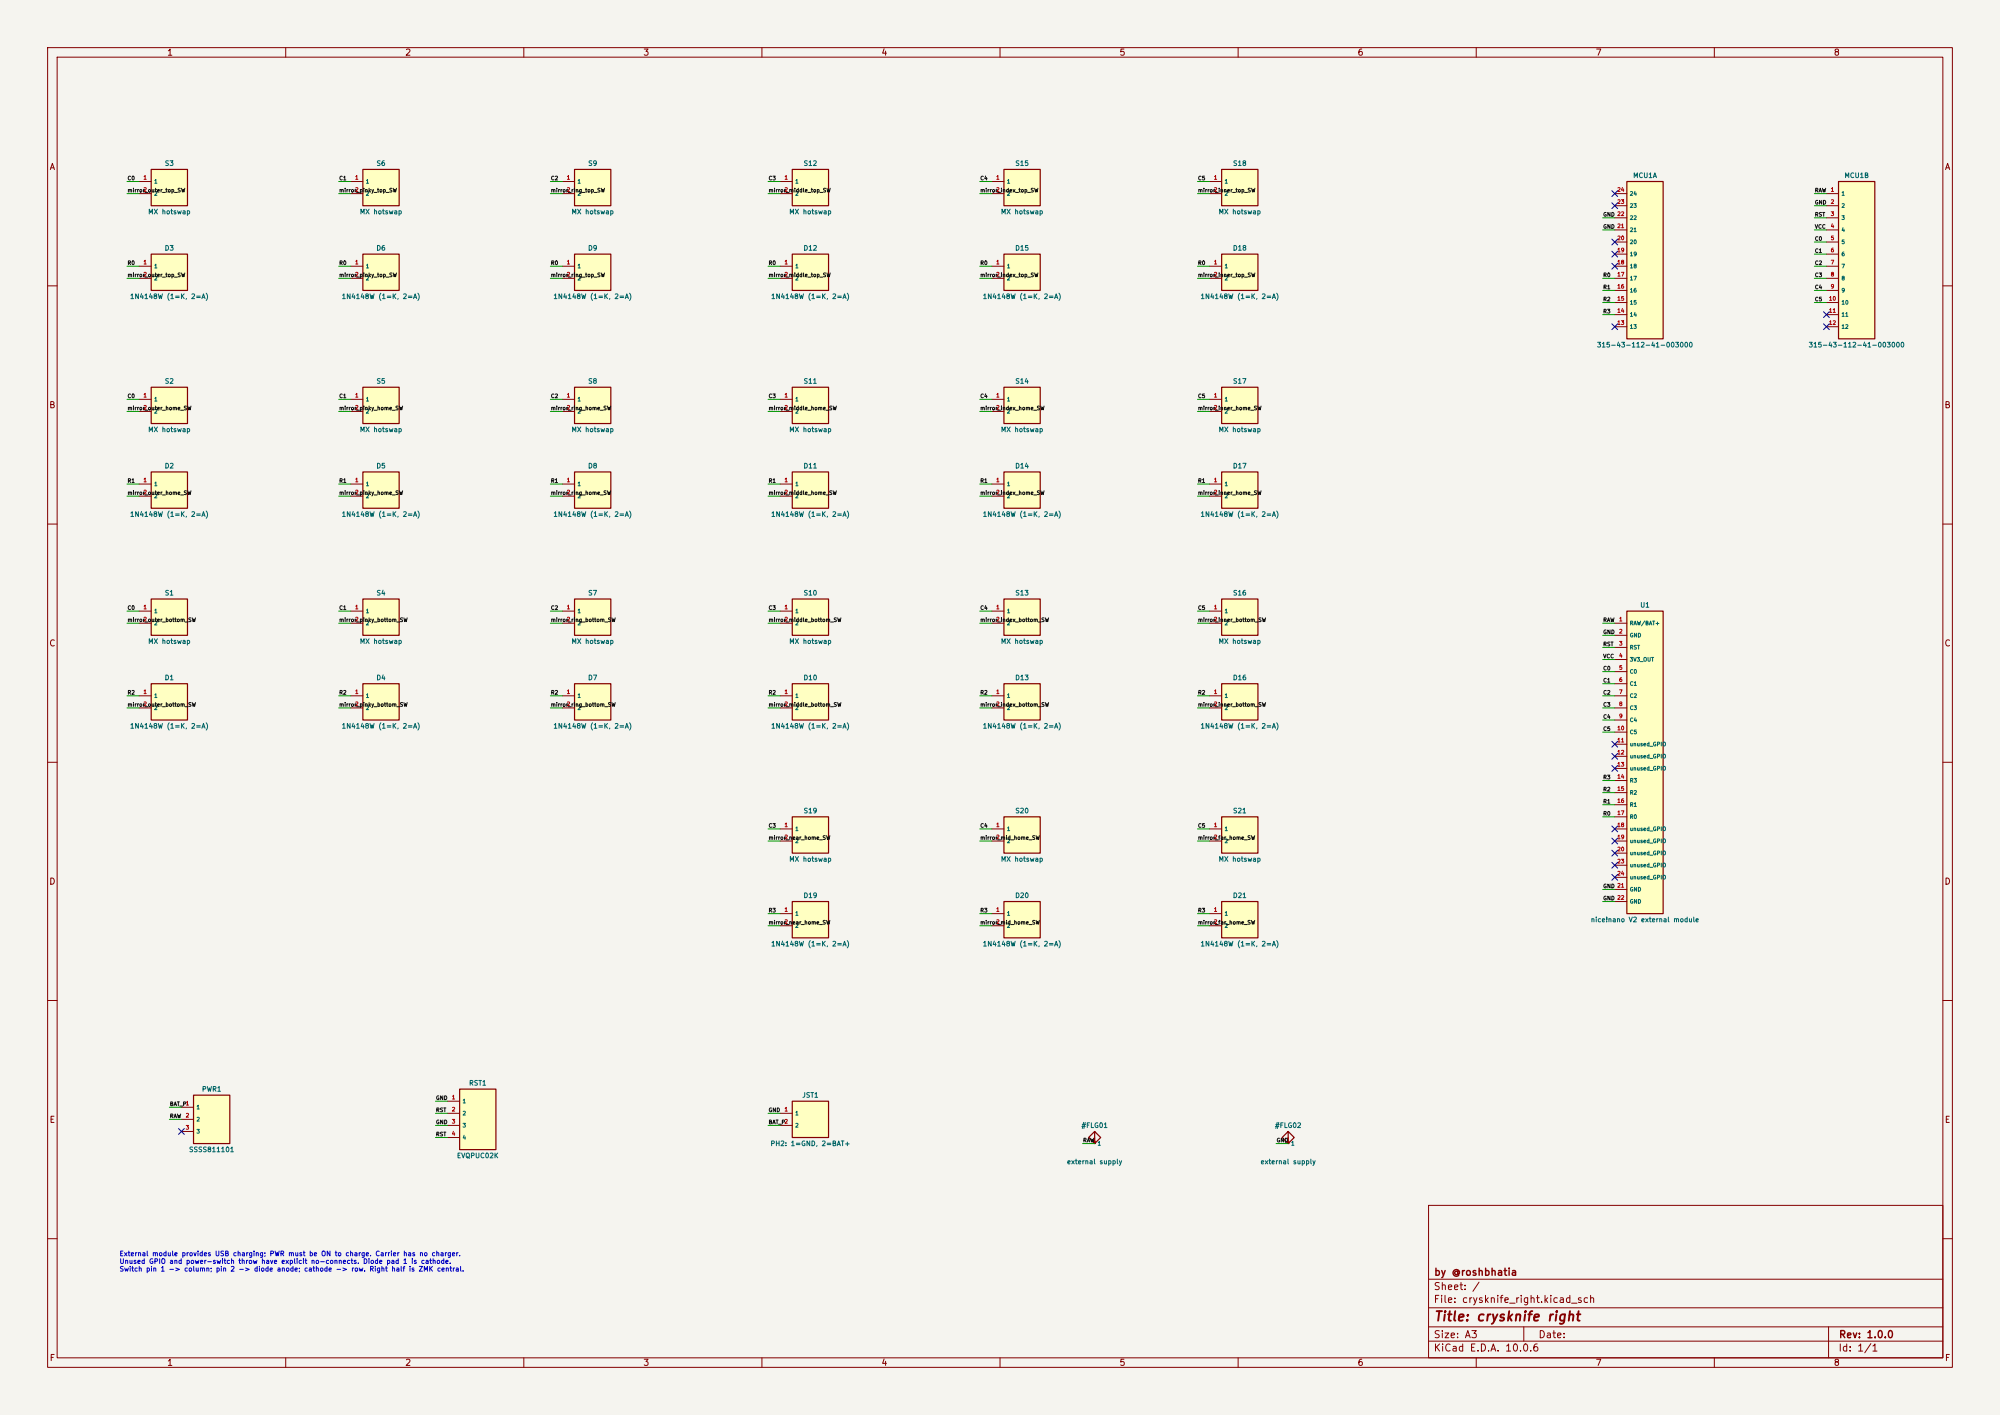
[picture p63: page 1]

nice!nano V2 external module

RST External module provides USB charging; PWR must be ON to charge. Carrier has no charger. Unused GPIO and power-switch throw have explicit no-connects. Diode pad 1 is cathode. Switch pin 1 -> column; pin 2 -> diode anode; cathode -> row. Right half is ZMK central.

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
