roshbhatia/crysknife/out/kicad/crysknife_left.kicad_pcb

## KiCad design out/kicad/crysknife_left.kicad_pcb (2026-10-09)

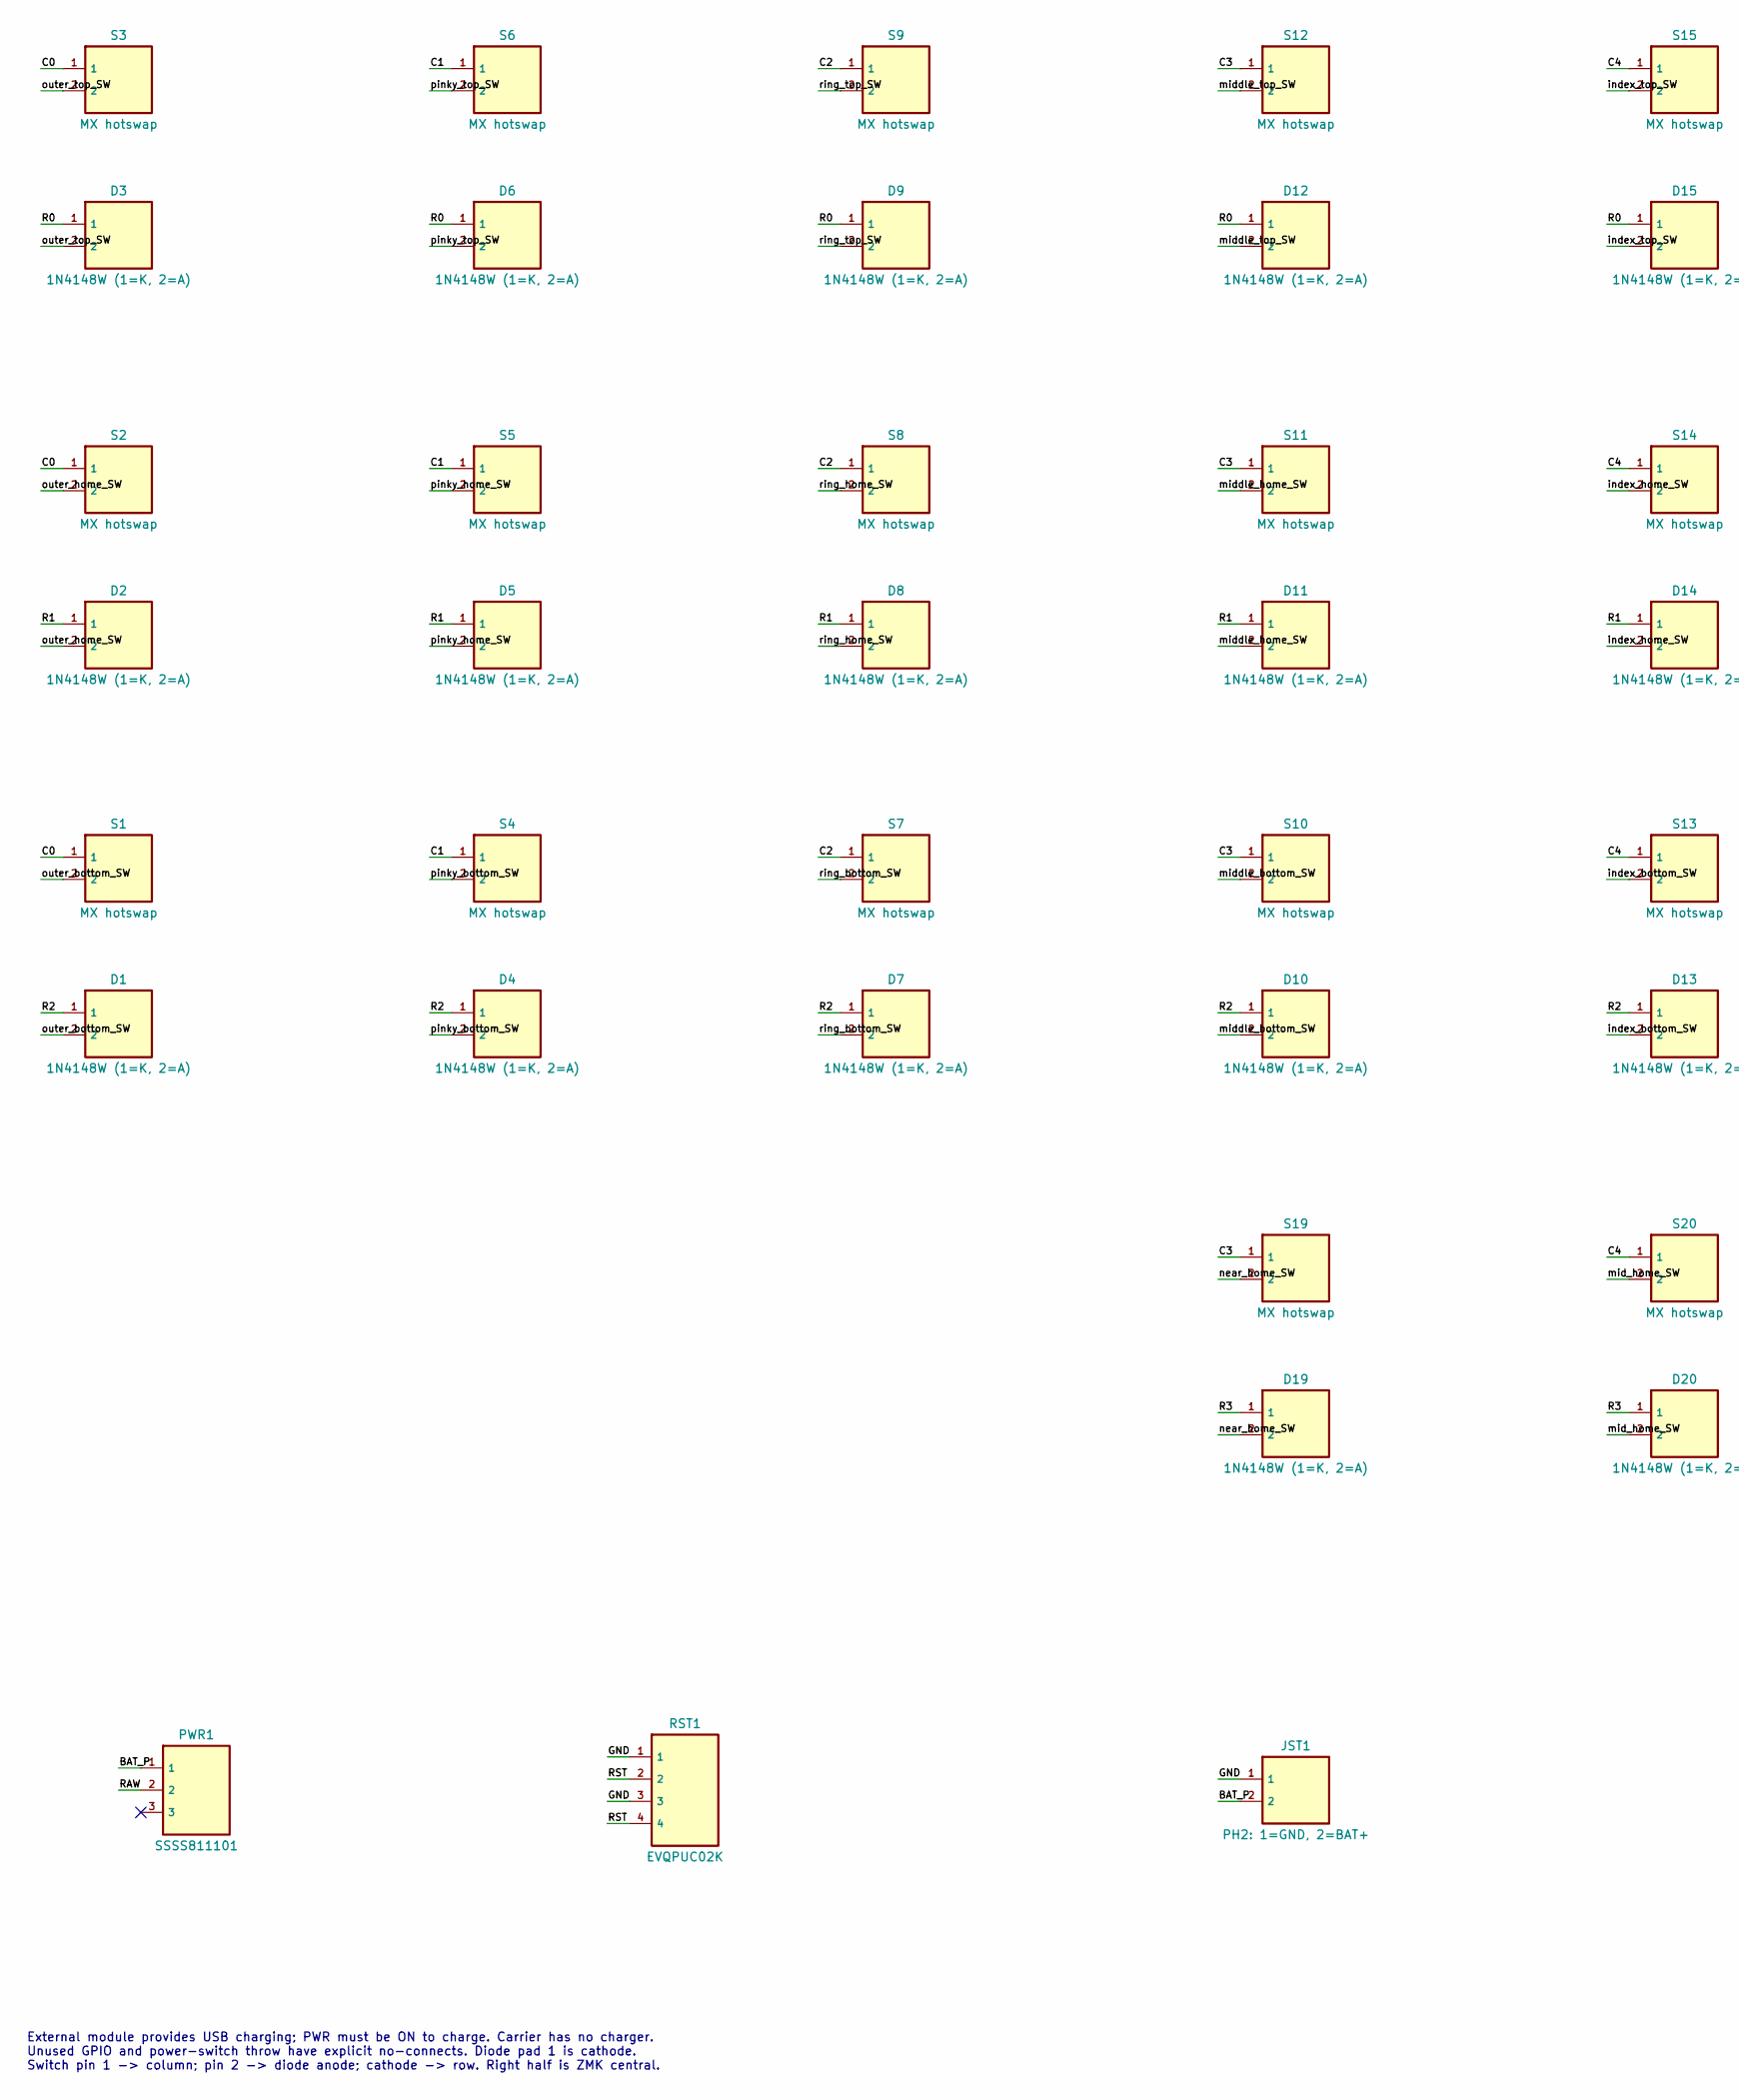
[picture p64: schematic crysknife_left.kicad_sch, crysknife left, part in row 1, column 1]

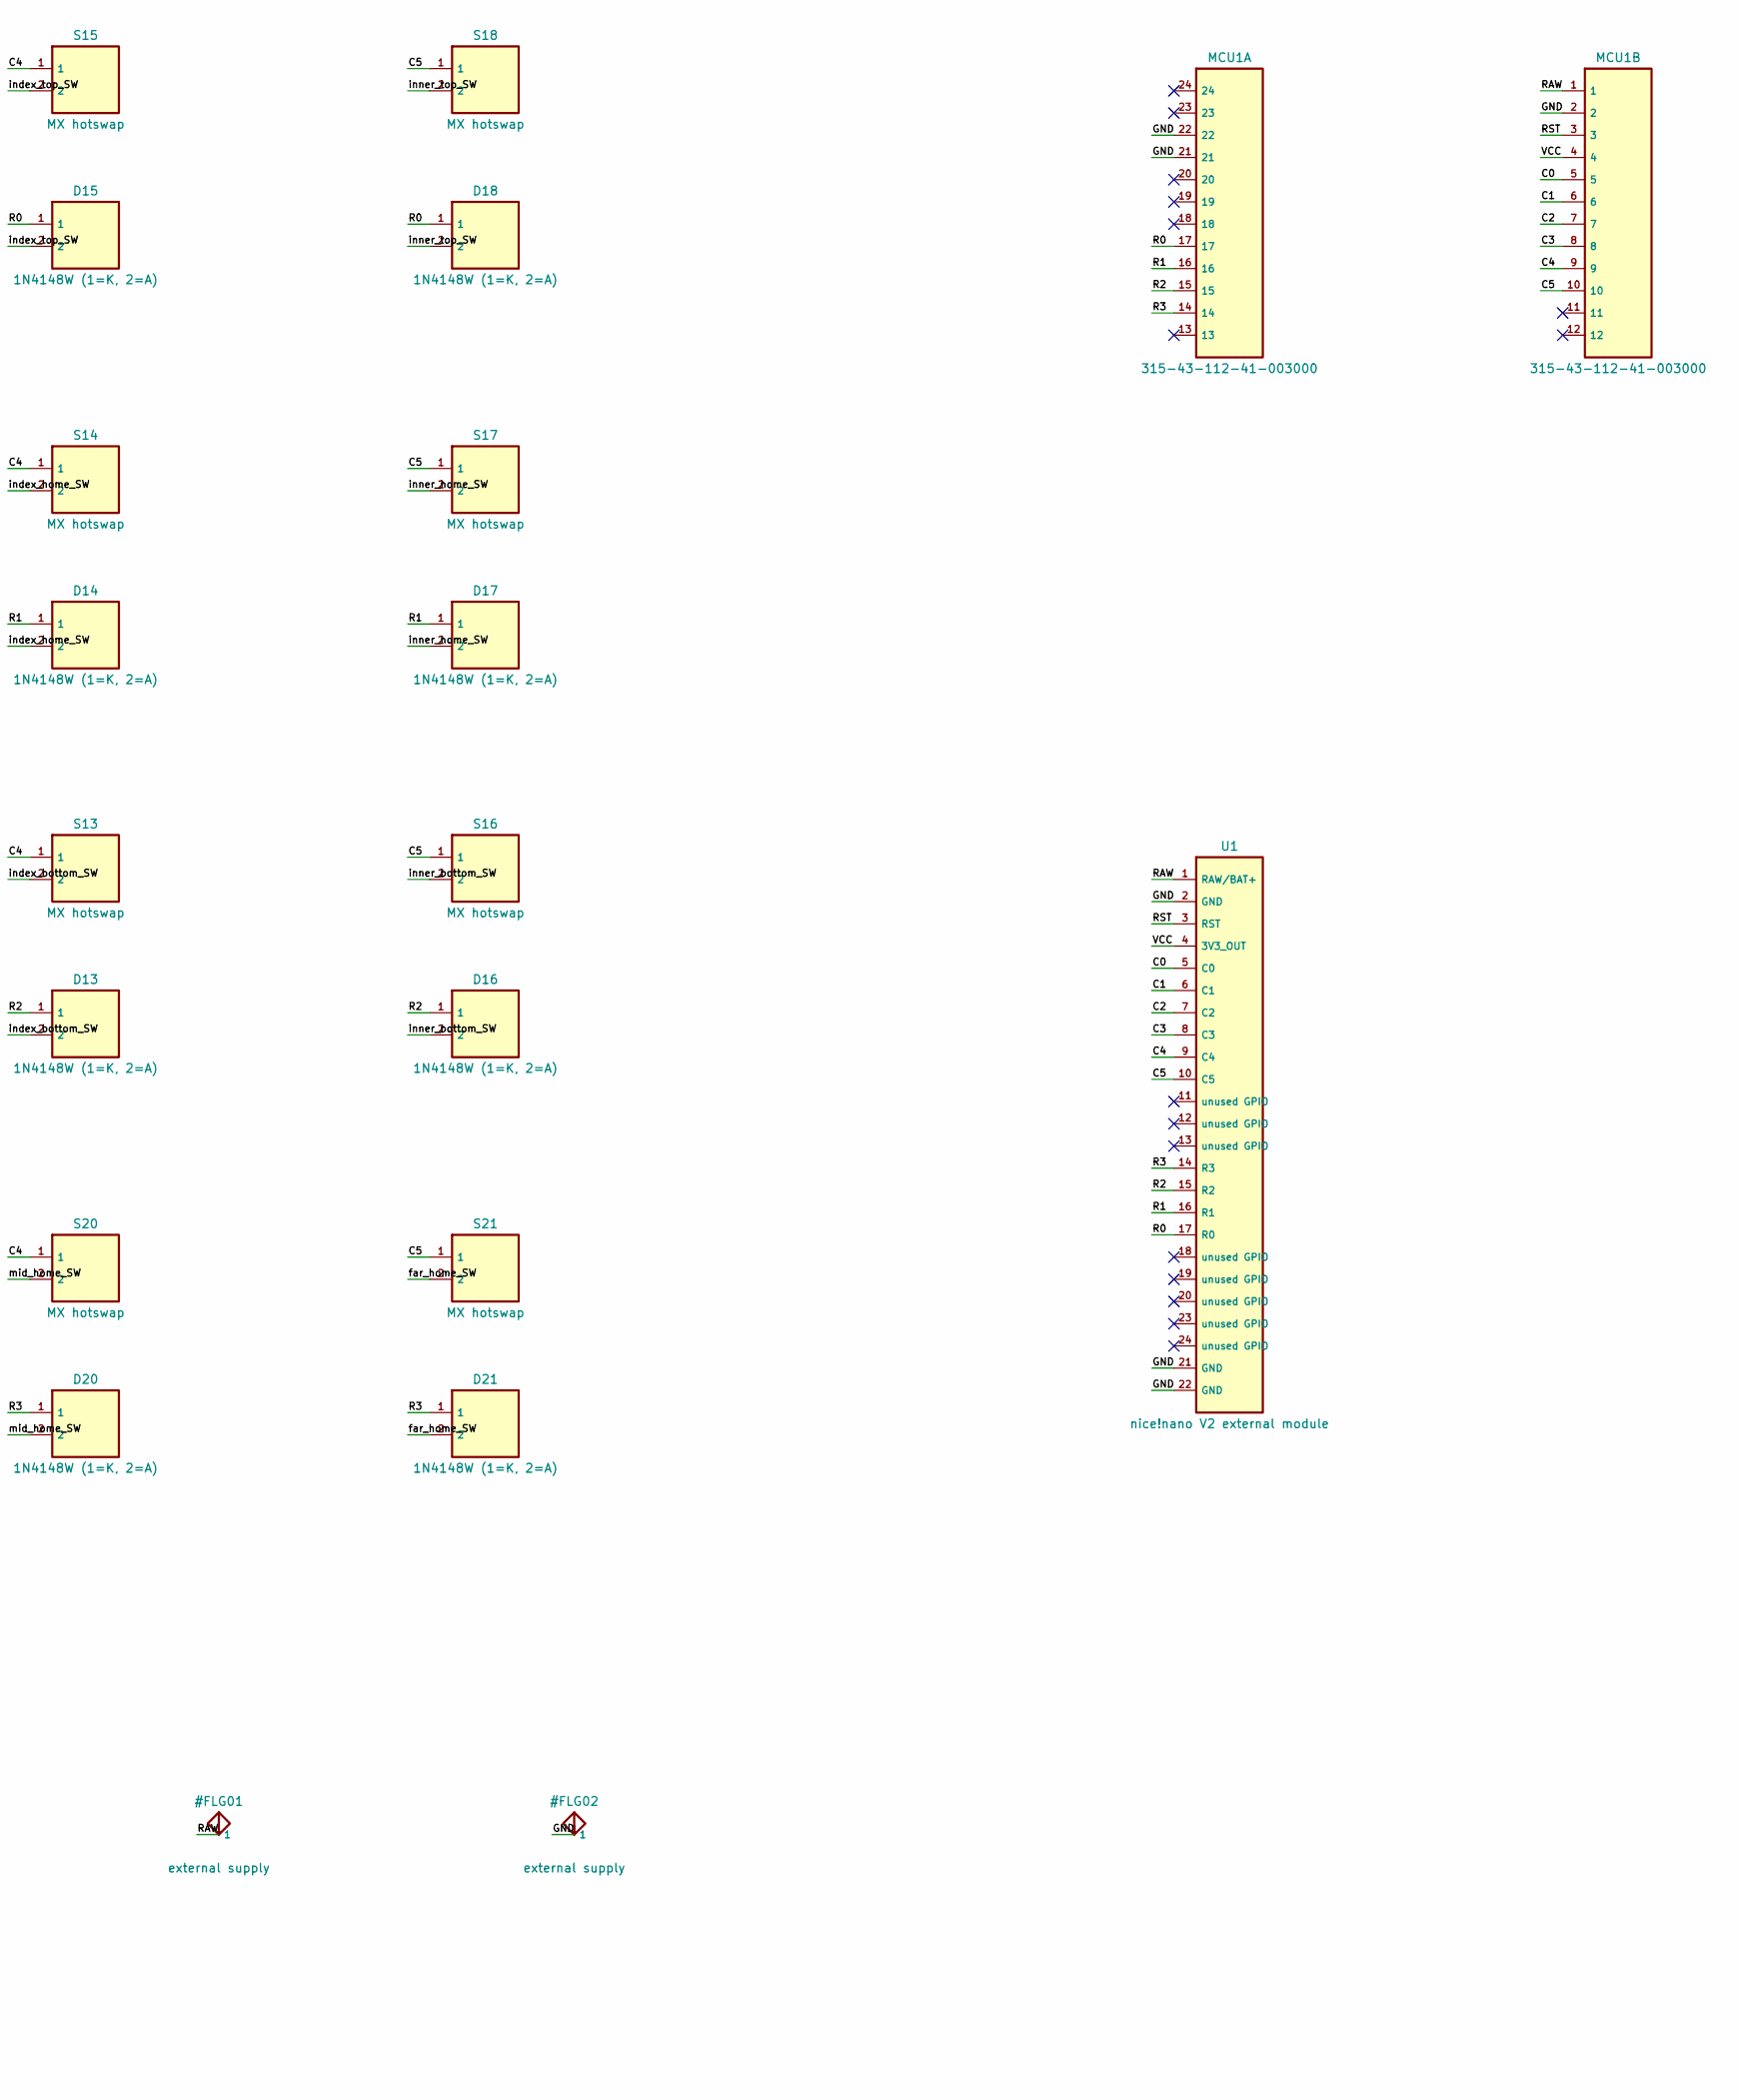
[picture p65: schematic crysknife_left.kicad_sch, crysknife left, part in row 1, column 2]

Parts:
D1: 1N4148W (1=K, 2=A); D1
D2: 1N4148W (1=K, 2=A); D2
D3: 1N4148W (1=K, 2=A); D3
D4: 1N4148W (1=K, 2=A); D4
D5: 1N4148W (1=K, 2=A); D5
D6: 1N4148W (1=K, 2=A); D6
D7: 1N4148W (1=K, 2=A); D7
D8: 1N4148W (1=K, 2=A); D8
D9: 1N4148W (1=K, 2=A); D9
D10: 1N4148W (1=K, 2=A); D10
D11: 1N4148W (1=K, 2=A); D11
D12: 1N4148W (1=K, 2=A); D12
D13: 1N4148W (1=K, 2=A); D13
D14: 1N4148W (1=K, 2=A); D14
D15: 1N4148W (1=K, 2=A); D15
D16: 1N4148W (1=K, 2=A); D16
D17: 1N4148W (1=K, 2=A); D17
D18: 1N4148W (1=K, 2=A); D18
D19: 1N4148W (1=K, 2=A); D19
D20: 1N4148W (1=K, 2=A); D20
D21: 1N4148W (1=K, 2=A); D21
JST1: PH2: 1=GND, 2=BAT+; JST1
MCU1A: 315-43-112-41-003000; MCU1A
MCU1B: 315-43-112-41-003000; MCU1B
PWR1: SSSS811101; PWR1
RST1: EVQPUC02K; RST1
S1: MX hotswap; S1
S2: MX hotswap; S2
S3: MX hotswap; S3
S4: MX hotswap; S4
S5: MX hotswap; S5
S6: MX hotswap; S6
S7: MX hotswap; S7
S8: MX hotswap; S8
S9: MX hotswap; S9
S10: MX hotswap; S10
S11: MX hotswap; S11
S12: MX hotswap; S12
S13: MX hotswap; S13
S14: MX hotswap; S14
S15: MX hotswap; S15
S16: MX hotswap; S16
S17: MX hotswap; S17
S18: MX hotswap; S18
S19: MX hotswap; S19
S20: MX hotswap; S20
S21: MX hotswap; S21
U1: nice!nano V2 external module

Connections:
BAT_P: JST1.2, PWR1.1
C0: MCU1B.5, S1.1, S2.1, S3.1, U1.5 (C0)
C1: MCU1B.6, S4.1, S5.1, S6.1, U1.6 (C1)
C2: MCU1B.7, S7.1, S8.1, S9.1, U1.7 (C2)
C3: MCU1B.8, S10.1, S11.1, S12.1, S19.1, U1.8 (C3)
C4: MCU1B.9, S13.1, S14.1, S15.1, S20.1, U1.9 (C4)
C5: MCU1B.10, S16.1, S17.1, S18.1, S21.1, U1.10 (C5)
GND: JST1.1, MCU1A.21, MCU1A.22, MCU1B.2, RST1.1, RST1.3, U1.2 (GND), U1.21 (GND), U1.22 (GND)
P0: MCU1A.23
P1: MCU1A.24
P2: MCU1A.20
P3: MCU1A.19
P4: MCU1A.18
P9: MCU1A.13
P10: MCU1B.12
P16: MCU1B.11
R0: D3.1, D6.1, D9.1, D12.1, D15.1, D18.1, MCU1A.17, U1.17 (R0)
R1: D2.1, D5.1, D8.1, D11.1, D14.1, D17.1, MCU1A.16, U1.16 (R1)
R2: D1.1, D4.1, D7.1, D10.1, D13.1, D16.1, MCU1A.15, U1.15 (R2)
R3: D19.1, D20.1, D21.1, MCU1A.14, U1.14 (R3)
RAW: MCU1B.1, PWR1.2, U1.1 (RAW/BAT+)
RST: MCU1B.3, RST1.2, RST1.4, U1.3 (RST)
VCC: MCU1B.4, U1.4 (3V3_OUT)
far_home_SW: D21.2, S21.2
index_bottom_SW: D13.2, S13.2
index_home_SW: D14.2, S14.2
index_top_SW: D15.2, S15.2
inner_bottom_SW: D16.2, S16.2
inner_home_SW: D17.2, S17.2
inner_top_SW: D18.2, S18.2
mid_home_SW: D20.2, S20.2
middle_bottom_SW: D10.2, S10.2
middle_home_SW: D11.2, S11.2
middle_top_SW: D12.2, S12.2
near_home_SW: D19.2, S19.2
outer_bottom_SW: D1.2, S1.2
outer_home_SW: D2.2, S2.2
outer_top_SW: D3.2, S3.2
pinky_bottom_SW: D4.2, S4.2
pinky_home_SW: D5.2, S5.2
pinky_top_SW: D6.2, S6.2
ring_bottom_SW: D7.2, S7.2
ring_home_SW: D8.2, S8.2
ring_top_SW: D9.2, S9.2

Notes on the sheet:
External module provides USB charging; PWR must be ON to charge. Carrier has no charger. Unused GPIO and power-switch throw have explicit no-connects. Diode pad 1 is cathode. Switch pin 1 -> column; pin 2 -> diode anode; cathode -> row. Right half is ZMK central.

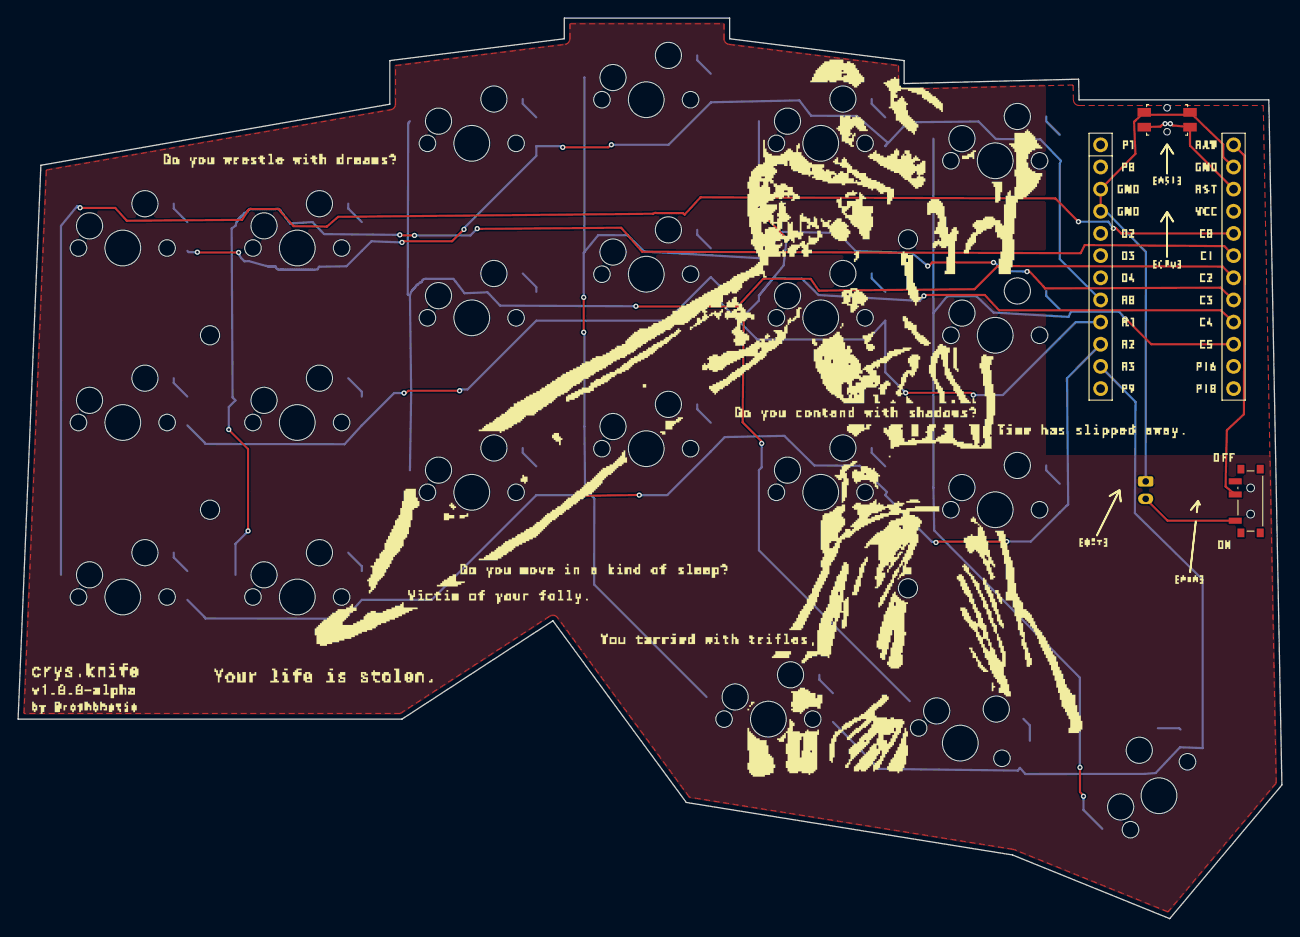
[picture p66: board crysknife_left.kicad_pcb from above]

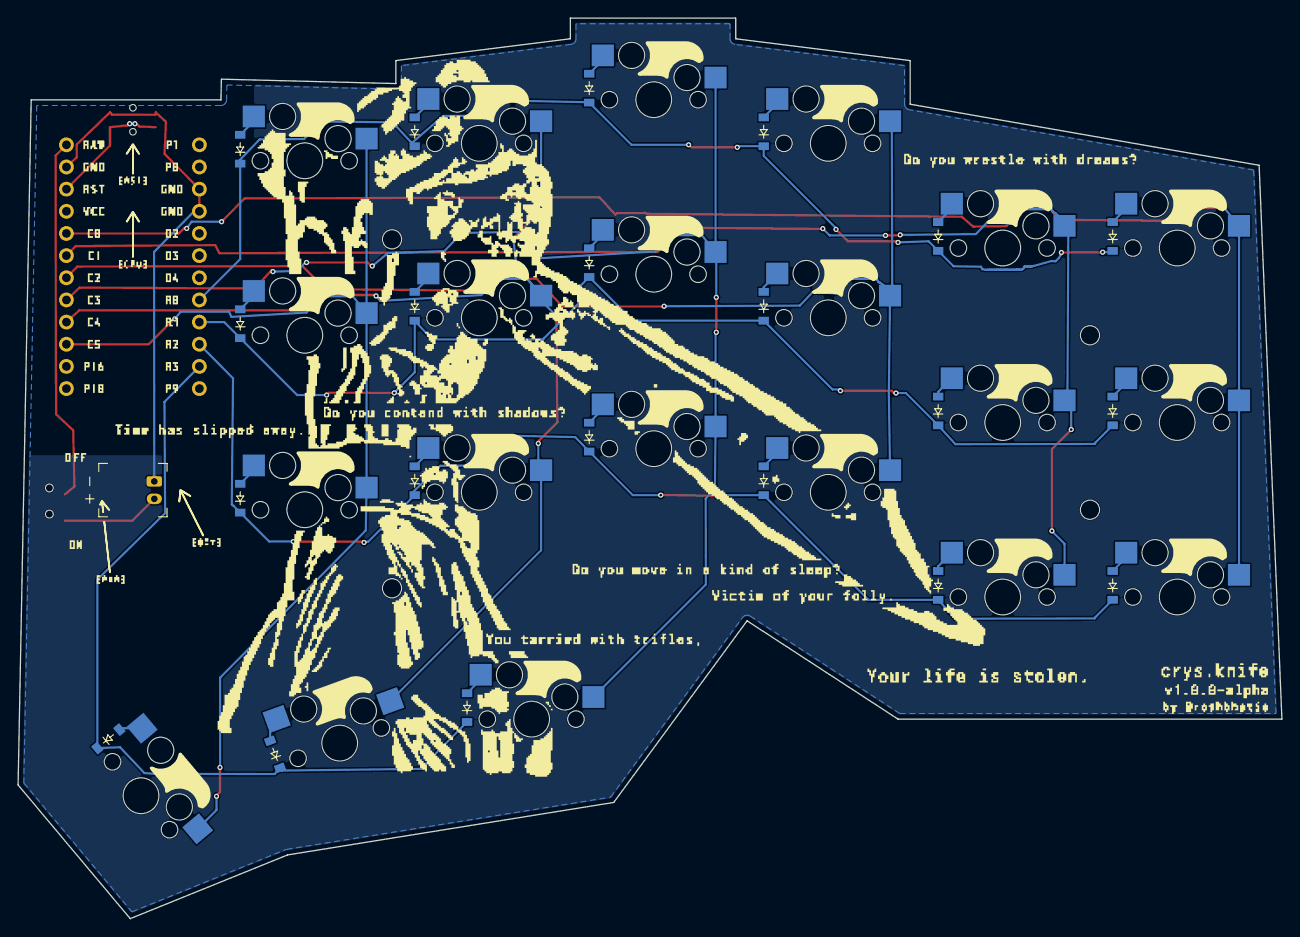
[picture p67: board crysknife_left.kicad_pcb from below]

Board: 2 copper layers, 144.9 x 103.2 mm, 53 parts (45 on the bottom side), 35 nets.

Other parts of the board:
ART1: knife-silkscreen
MCU1: mcu_nice_nano
MH1, MH2, MH3, MH4: mounting_hole_npth
