roshbhatia/crysknife/scripts/save_outputs.py

import argparse
import hashlib
import json
from pathlib import Path
import shutil
import zipfile

ROOT = Path(__file__).resolve().parents[1]
parser = argparse.ArgumentParser(description='Save checked engineering models and vendor files')
parser.add_argument('--evidence-dir', type=Path, required=True)
parser.add_argument('--run-url', required=True)
parser.add_argument('--revision', required=True)
args = parser.parse_args()
evidence = args.evidence_dir.resolve()
out = ROOT/'out'
kicad = out/'kicad'
jlc = ROOT/'manufacturing/jlcpcb'
scs = ROOT/'manufacturing/sendcutsend'
for directory in (kicad, jlc, scs, out/'3d'):
    directory.mkdir(parents=True, exist_ok=True)
verification = {'pcb_revision':args.revision, 'pcb_ci':args.run_url,
                'status':'ERC and DRC passed', 'boards':{}}
for side in ('left', 'right'):
    erc = json.loads((evidence/f'schematic/{side}-erc.json').read_text())
    assert not [v for s in erc['sheets'] for v in s['violations']], (side, 'ERC issues')
    drc = json.loads((evidence/f'pcb/{side}-routed-drc.json').read_text())
    assert not drc['unconnected_items'], (side, 'Unconnected copper')
    assert all(v['severity']=='warning' and v['type']=='lib_footprint_issues' for v in drc['violations']), (side, 'DRC issues')
    board = evidence/f'pcb/crysknife_{side}_routed.kicad_pcb'
    verification['boards'][side] = {'erc_issues':0, 'drc_errors':0, 'unconnected':0,
                                  'library_warnings':len(drc['violations']),
                                  'sha256':hashlib.sha256(board.read_bytes()).hexdigest()}
    shutil.copyfile(board, kicad/f'crysknife_{side}.kicad_pcb')
    for extension in ('kicad_sch', 'kicad_pro'):
        shutil.copyfile(evidence/f'schematic/crysknife_{side}.{extension}', kicad/f'crysknife_{side}.{extension}')
    for extension in ('pdf', 'net'):
        shutil.copyfile(evidence/f'schematic/{side}.{extension}', kicad/f'{side}.{extension}')
    assembly = evidence/'manufacturing/assembly'
    for kind in ('bom', 'cpl'):
        shutil.copyfile(assembly/f'{side}-{kind}.csv', jlc/f'{side}-{kind}.csv')
    with zipfile.ZipFile(jlc/f'{side}-gerbers.zip','w',zipfile.ZIP_DEFLATED) as archive:
        for file in sorted((assembly/f'gerbers/{side}').iterdir()):
            archive.writestr(zipfile.ZipInfo(file.name, (1980,1,1,0,0,0)), file.read_bytes(), compress_type=zipfile.ZIP_DEFLATED)
    for part in ('bottom-flat','rf-insert','plate','damping'):
        shutil.copyfile(ROOT/f'build/case/{side}-{part}.dxf', scs/f'{side}-{part}.dxf')

for name in ('crysknife.kicad_sym','sym-lib-table','fp-lib-table'):
    shutil.copyfile(evidence/f'schematic/{name}', kicad/name)
shutil.copytree(evidence/'schematic/crysknife.pretty', kicad/'crysknife.pretty', dirs_exist_ok=True)
shutil.copyfile(ROOT/'build/case/mechanical-checks.json', scs/'mechanical-checks.json')
for extension in ('dxf','svg'):
    shutil.copyfile(ROOT/f'build/case/switch-fit-coupon.{extension}', scs/f'switch-fit-coupon.{extension}')
for side in ('left','right'):
    for part in ('assembly','bottom'):
        name = 'metal-bottom' if part == 'bottom' else part
        shutil.copyfile(ROOT/f'build/case/{side}-{part}.3mf', out/f'3d/{side}-{name}.3mf')
(out/'validation.json').write_text(json.dumps(verification,indent=2)+'\n')
print('Saved KiCad projects, case models, and vendor files')
