roshbhatia/crysknife/(commit log)

2026-10-07 feat(layout): establish Fridakeeb MX Corne prototype
    Assisted-by: Codex
2026-10-07 feat(pcb): generate dedicated MX wireless board drafts
    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
2026-10-07 fix(firmware): freeze only active West dependencies
    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
    [build_firmware.py]
2026-10-07 feat(pcb): add Frida silkscreen and remote KiCad checks
    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
2026-10-07 fix(ci): align KiCad container user with runner permissions
    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
2026-10-07 fix(pcb): qualify the artwork footprint library identifier
    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
    [add_artwork.py]
2026-10-07 fix(checks): verify artwork identity and imported pad count
    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
    [add_artwork.py]
2026-10-07 fix(ci): export PCB previews with explicit SVG filenames
    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
2026-10-07 feat(pcb): integrate tscircuit routing with KiCad validation
    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
2026-10-07 fix(build): declare Bun and tighten routing validation
    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
    [check_drc_draft.py, check_tscircuit.py]
2026-10-07 fix(pcb): check pad copper layer sets through KiCad
    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
    [build_tscircuit.py, check_conversion_guards.py]
2026-10-07 fix(pcb): match routing clearances to KiCad constraints
    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
    [generate_tscircuit.py]
2026-10-07 fix(pcb): preserve socket pad clearance at the board edge
    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
    [generate_tscircuit.py]
2026-10-07 fix(pcb): validate live DRC for both preview entries
    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
    [build_tscircuit.py, check_tscircuit.py, generate_tscircuit.py]
2026-10-07 feat(pcb): add white mask and Frida silkscreen to both previews
    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
2026-10-07 fix(pcb): preserve version digits and attribution in the legend
    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
    [add_artwork.py]
2026-10-08 feat(pcb): revise Fridacorne spacing and branding
    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
2026-10-08 fix(pcb): enforce via clearance to controller pads
    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
    [generate_tscircuit.py]
2026-10-08 feat(silkscreen): cover Fridakeys with Frida on both faces
    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
2026-10-08 fix(silkscreen): preserve component outlines and diode symbols
    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
    [add_artwork.py]
2026-10-08 fix(pcb): finish the right reset escape in KiCad
    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
2026-10-08 fix(pcb): preserve Frida artwork detail on both faces
    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
    [add_artwork.py]
2026-10-08 feat(pcb): validate the increased stagger and ground fills
    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
2026-10-08 feat(case): generate gasket sandwich layers from PCB geometry
    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
    [sandwich.scad]
2026-10-09 fix(pcb): finish via escapes and inset ground boundaries
    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
2026-10-09 fix(pcb): keep the reset escape clear of ground tracks
    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
2026-10-09 feat(pcb): add the plug-in TrackPoint interface
    Add ribbon, signal pull-ups, reset filtering, and supply decoupling on the right half. Verify the new pad mapping through tscircuit and the firmware source audit.
    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
    [add_artwork.py, check_drc_draft.py, check_electrical.py, check_tscircuit.py, pcb.yaml]
2026-10-09 feat(manufacturing): export the assembly quote inventory
    Bind every factory component to an exact catalog candidate and export per-half BOM/CPL drafts. Reject missing sockets, unknown parts, wrong faces, and footprint mismatches.
    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
    [check_assembly_guards.py, generate_assembly.py]
2026-10-09 fix(pcb): connect the battery ground directly to the pour
    The right TrackPoint routes constrain the battery thermal spokes. Use a scoped solid pad connection and verify it after saving the ground fill.
    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
2026-10-09 fix(pcb): match the ribbon connector mounting lands
    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
    [check_electrical.py]
2026-10-09 fix(pcb): separate conflicting via escapes on every net
    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
2026-10-09 feat(pcb): use factory-soldered nice!nano controller sockets
    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
2026-10-09 fix(pcb): source the ground pour from controller sockets
    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
2026-10-09 feat: prepare fridakeys wireless prototype
    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
    [sandwich.scad]
2026-10-09 fix: place schematic pins on grid and provide local libraries
    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
    [generate_schematic.py]
2026-10-09 feat: store editable circuit models and fresh previews
    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
    [geometry.scad, sandwich.scad]
2026-10-09 feat: simplify case and organize engineering exports
    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
    [fridakeys_left.kicad_pcb, fridakeys_left.kicad_sch, fridakeys_right.kicad_pcb, fridakeys_right.kicad_sch, geometry.scad, left-assembly.3mf, left-bom.csv, left-bottom-bent.dxf]
2026-10-09 feat: rename keyboard to crysknife
    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
    [left-bom.csv, right-bom.csv]
2026-10-09 feat: refine crysknife geometry for a flat case
    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
    [geometry.scad, left-assembly.3mf, left-bottom-bent.dxf, left-bottom-flat.dxf, left-bottom.3mf, left-damping.dxf, left-plate.dxf, parameters.scad]
2026-10-09 fix: mirror underside controller socket labels
    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
2026-10-09 feat: add a finished aluminum base
    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
    [left-assembly.3mf, left-bottom.3mf, parameters.scad, right-assembly.3mf, right-bottom.3mf, sandwich.scad]
2026-10-09 fix: widen the outer bottom key margins
    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
    [geometry.scad, left-assembly.3mf, left-bottom-flat.dxf, left-bottom.3mf, left-damping.dxf, left-plate.dxf, right-assembly.3mf, right-bottom-flat.dxf]
2026-10-09 docs: compare wireless Corne reference builds
    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
2026-10-09 feat: place knife and poetry on both PCB faces
    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
2026-10-09 fix: use M2 screw mounts and enlarge Ioskeley artwork
    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
    [geometry.scad, parameters.scad, sandwich.scad]
2026-10-09 fix: match component labels to pin text size
    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
    [add_artwork.py]
2026-10-09 fix: mirror knife artwork without moving the layout
    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
    [add_artwork.py]
2026-10-09 fix: separate same-net via drills during route finishing
    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
2026-10-09 chore: refresh checked fabrication exports and circuit audit
    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
    [crysknife_left.kicad_pcb, crysknife_left.kicad_sch, crysknife_right.kicad_pcb, crysknife_right.kicad_sch, fridakeys_left.kicad_pcb, fridakeys_left.kicad_sch, fridakeys_right.kicad_pcb, fridakeys_right.kicad_sch]
2026-10-09 docs: correct the M2 mounting footprint description
    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
2026-10-09 fix(manufacturing): correct JLC prototype placements
    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
    [left-assembly.3mf, left-bom.csv, parameters.scad, right-assembly.3mf, right-bom.csv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]
2026-10-09 fix(assembly): reverse hotswap socket body orientation
    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
    [left-cpl.csv, right-cpl.csv]
2026-10-09 feat(case): add printed tray prototypes and supplier quotes
    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
    [left-plate.3mf, left-plate.stl, left-printed-plate.3mf, left-printed-tray.3mf, left-tray.3mf, left-tray.stl, plate-geometry.scad, printed-plate.scad]
2026-10-09 feat(case): add removable TPU sleeves with closed bottoms
    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
    [left-plate.3mf, left-printed-plate.3mf, left-printed-sleeve.3mf, left-printed-tray.3mf, left-sleeve.3mf, left-sleeve.stl, left-tray.3mf, left-tray.stl]
2026-10-09 feat(case): add sleeve retaining lips over plate edges
    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
    [left-plate.3mf, left-printed-plate.3mf, left-printed-sleeve.3mf, left-printed-tray.3mf, left-sleeve.3mf, left-sleeve.stl, left-tray.3mf, left-tray.stl]
2026-10-09 feat(case): wrap wider flat plates in a TPU case
    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
    [left-assembly.3mf, left-bottom-flat.dxf, left-bottom.3mf, left-damping.dxf, left-plate.3mf, left-plate.dxf, left-plate.stl, left-printed-plate.3mf]
2026-10-09 docs(case): record updated TPU cart and quote
    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
2026-10-09 feat(case): restore printable plates in JLC cart
    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
    [left-bottom.3mf, left-plate.3mf, left-printed-sleeve.3mf, left-sleeve.3mf, left-sleeve.stl, plate-geometry.scad, printed-plate.scad, right-bottom.3mf]
2026-10-13 feat(case): compare four enclosure constructions
    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
    [cnc-switch-fit.dxf, cnc-switch-fit.step, cnc-switch-fit.stl, hardware.csv, left-bottom.dxf, left-bottom.step, left-bottom.stl, left-frame.step]
2026-10-13 feat(case): review assembled height and thinner rigid base
    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
    [hardware.csv, height-review.csv, left-bottom.dxf, left-bottom.step, left-bottom.stl, left-rf-insert.dxf, left-rf-insert.step, left-rf-insert.stl]
2026-10-13 feat(firmware): enable battery-powered deep sleep
    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
2026-10-13 docs(battery): qualify the thinner 750 mAh candidate
    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
2026-10-13 docs(battery): record connector photo polarity mapping
    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
2026-10-13 feat(case): adopt the 750 mAh lower prototype stack
    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
    [battery.scad, hardware.csv, left-assembly.3mf, left-bottom-flat.dxf, left-bottom.dxf, left-bottom.step, left-bottom.stl, left-damping.dxf]
2026-10-13 docs(assembly): align references with the 750 mAh prototype
    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
2026-10-13 fix(exports): keep resin and metal bottom models separate
    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
    [left-metal-bottom.3mf, right-metal-bottom.3mf]
